Hobbit13/hackeeg-shield/eagle/BioRoboticsShield.jpg

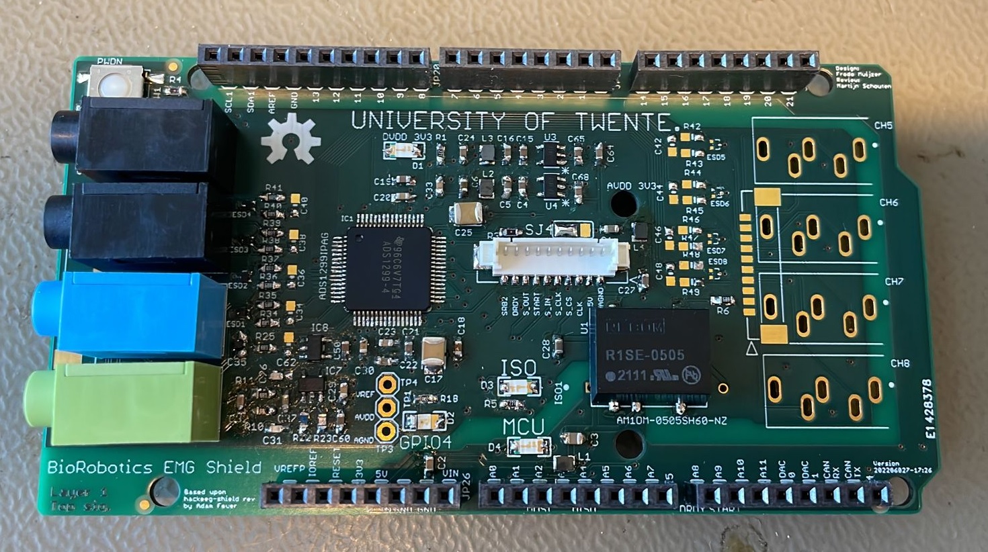
eagle/BioRoboticsShield.jpg
