Hobbit13/hackeeg-shield/eagle/biorobotics_EMG_shield.pdf

A

A

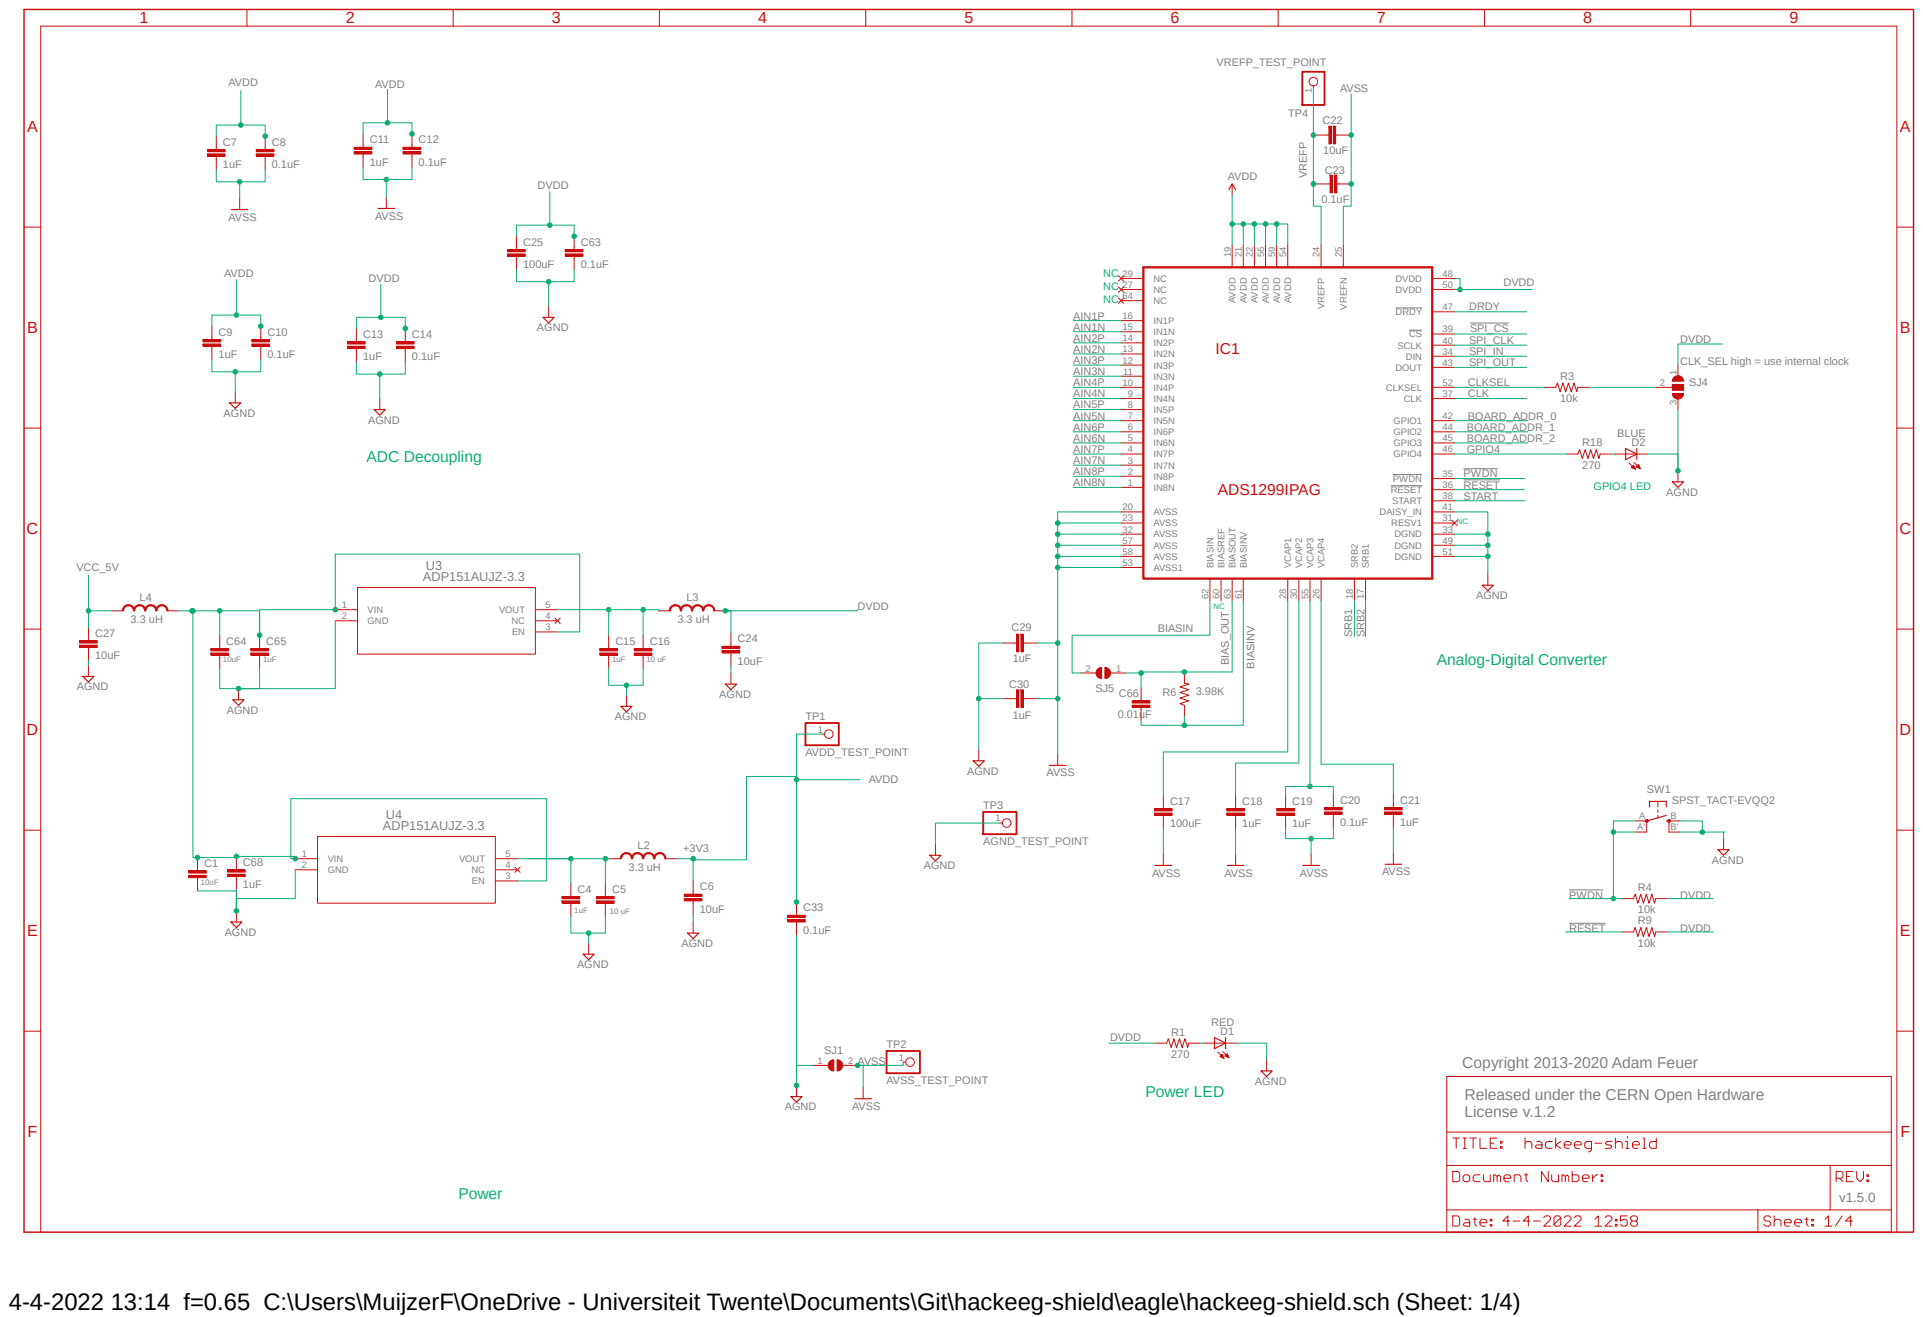
[picture p18: page 1]

DVDD
CLK_SEL high = use internal clock

BIASINV 61 BIASOUT 63 BIASREF 60 BIASIN 62

Copyright 2013-2020 Adam Feuer
Released under the CERN Open Hardware
License v.1.2

4-4-2022 13:14 f=0.65 C:\Users\MuijzerF\OneDrive - Universiteit Twente\Documents\Git\hackeeg-shield\eagle\hackeeg-shield.sch (Sheet: 1/4)

A

A

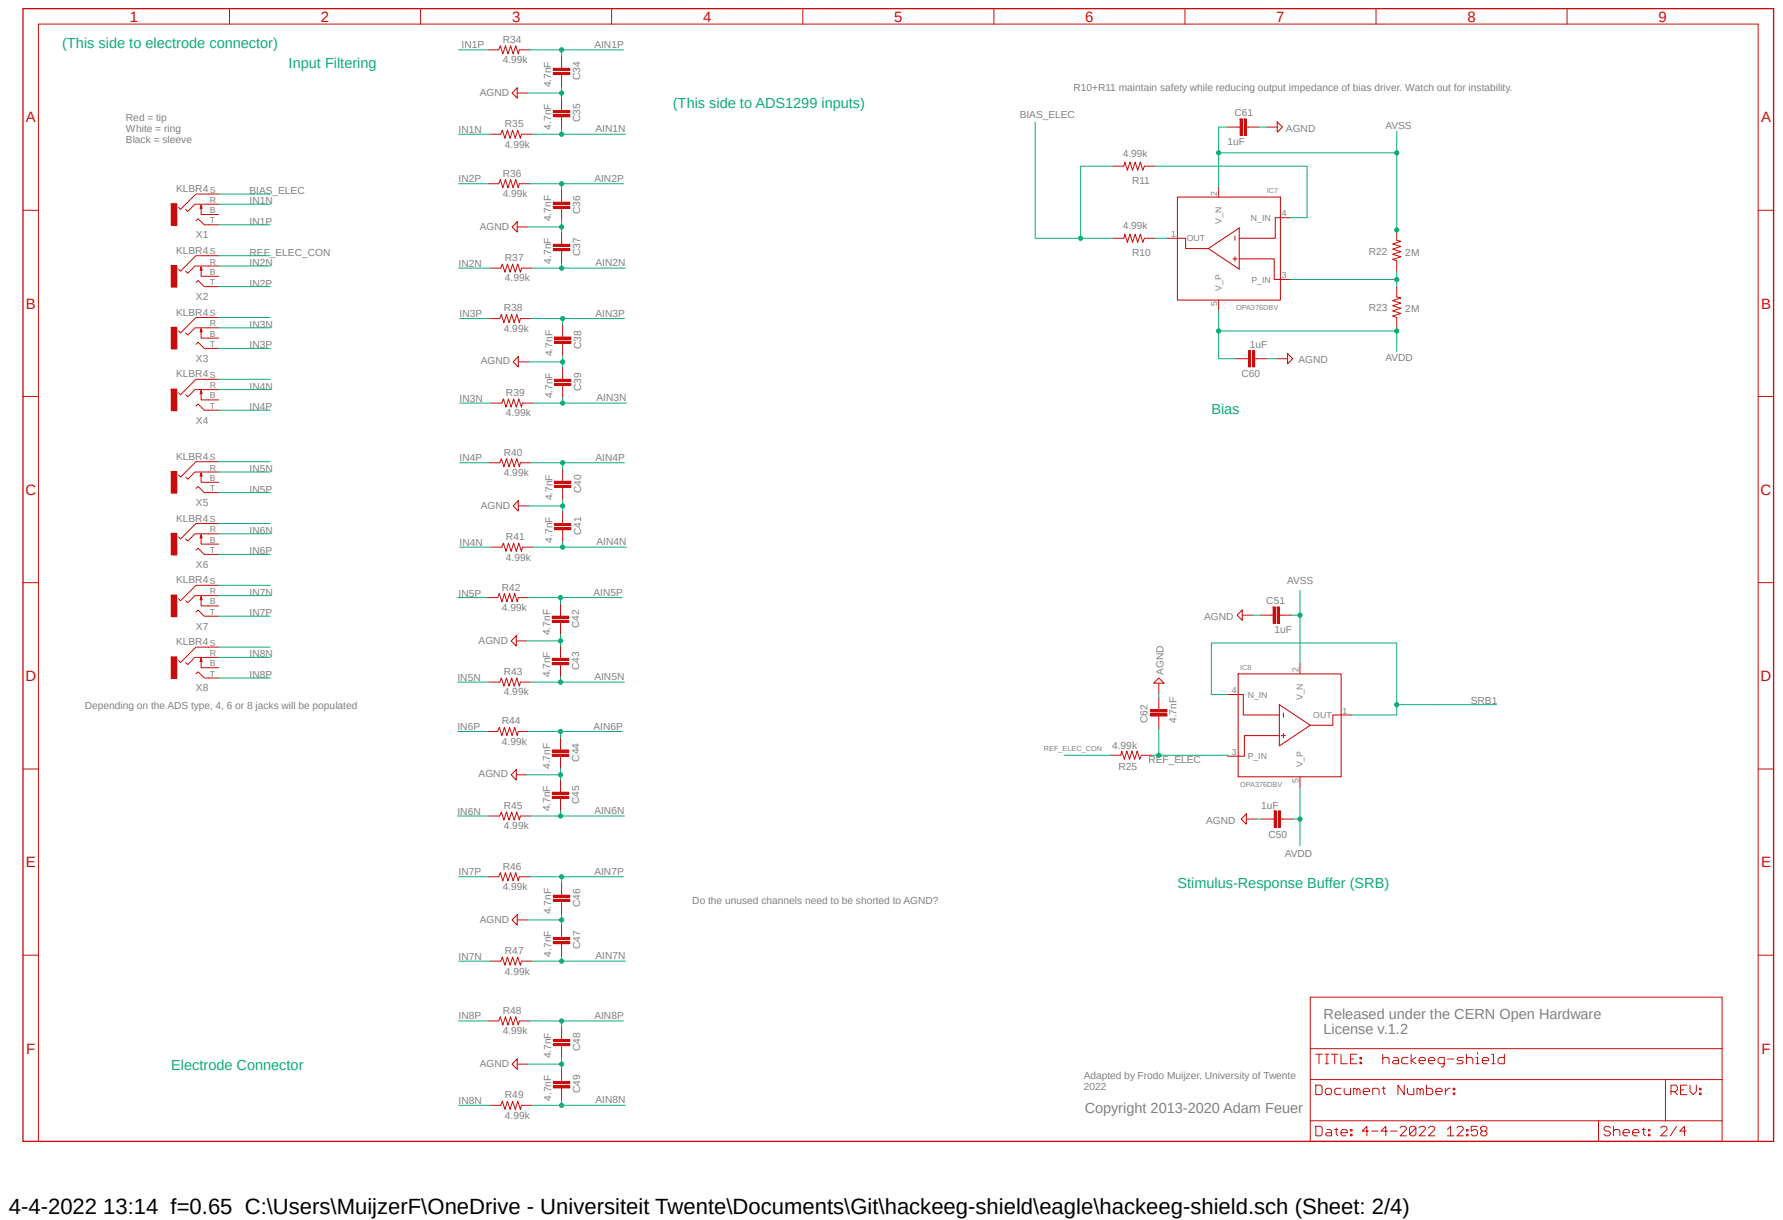
[picture p19: page 2]

(This side to electrode connector)

R10+R11 maintain safety while reducing output impedance of bias driver. Watch out for instability.

(This side to ADS1299 inputs)

Depending on the ADS type, 4, 6 or 8 jacks will be populated

Stimulus-Response Buffer (SRB)

Do the unused channels need to be shorted to AGND?

Released under the CERN Open Hardware
License v.1.2

Adapted by Frodo Muijzer, University of Twente
Copyright 2013-2020 Adam Feuer

4-4-2022 13:14 f=0.65 C:\Users\MuijzerF\OneDrive - Universiteit Twente\Documents\Git\hackeeg-shield\eagle\hackeeg-shield.sch (Sheet: 2/4)

## R1SE-0505-R

U1

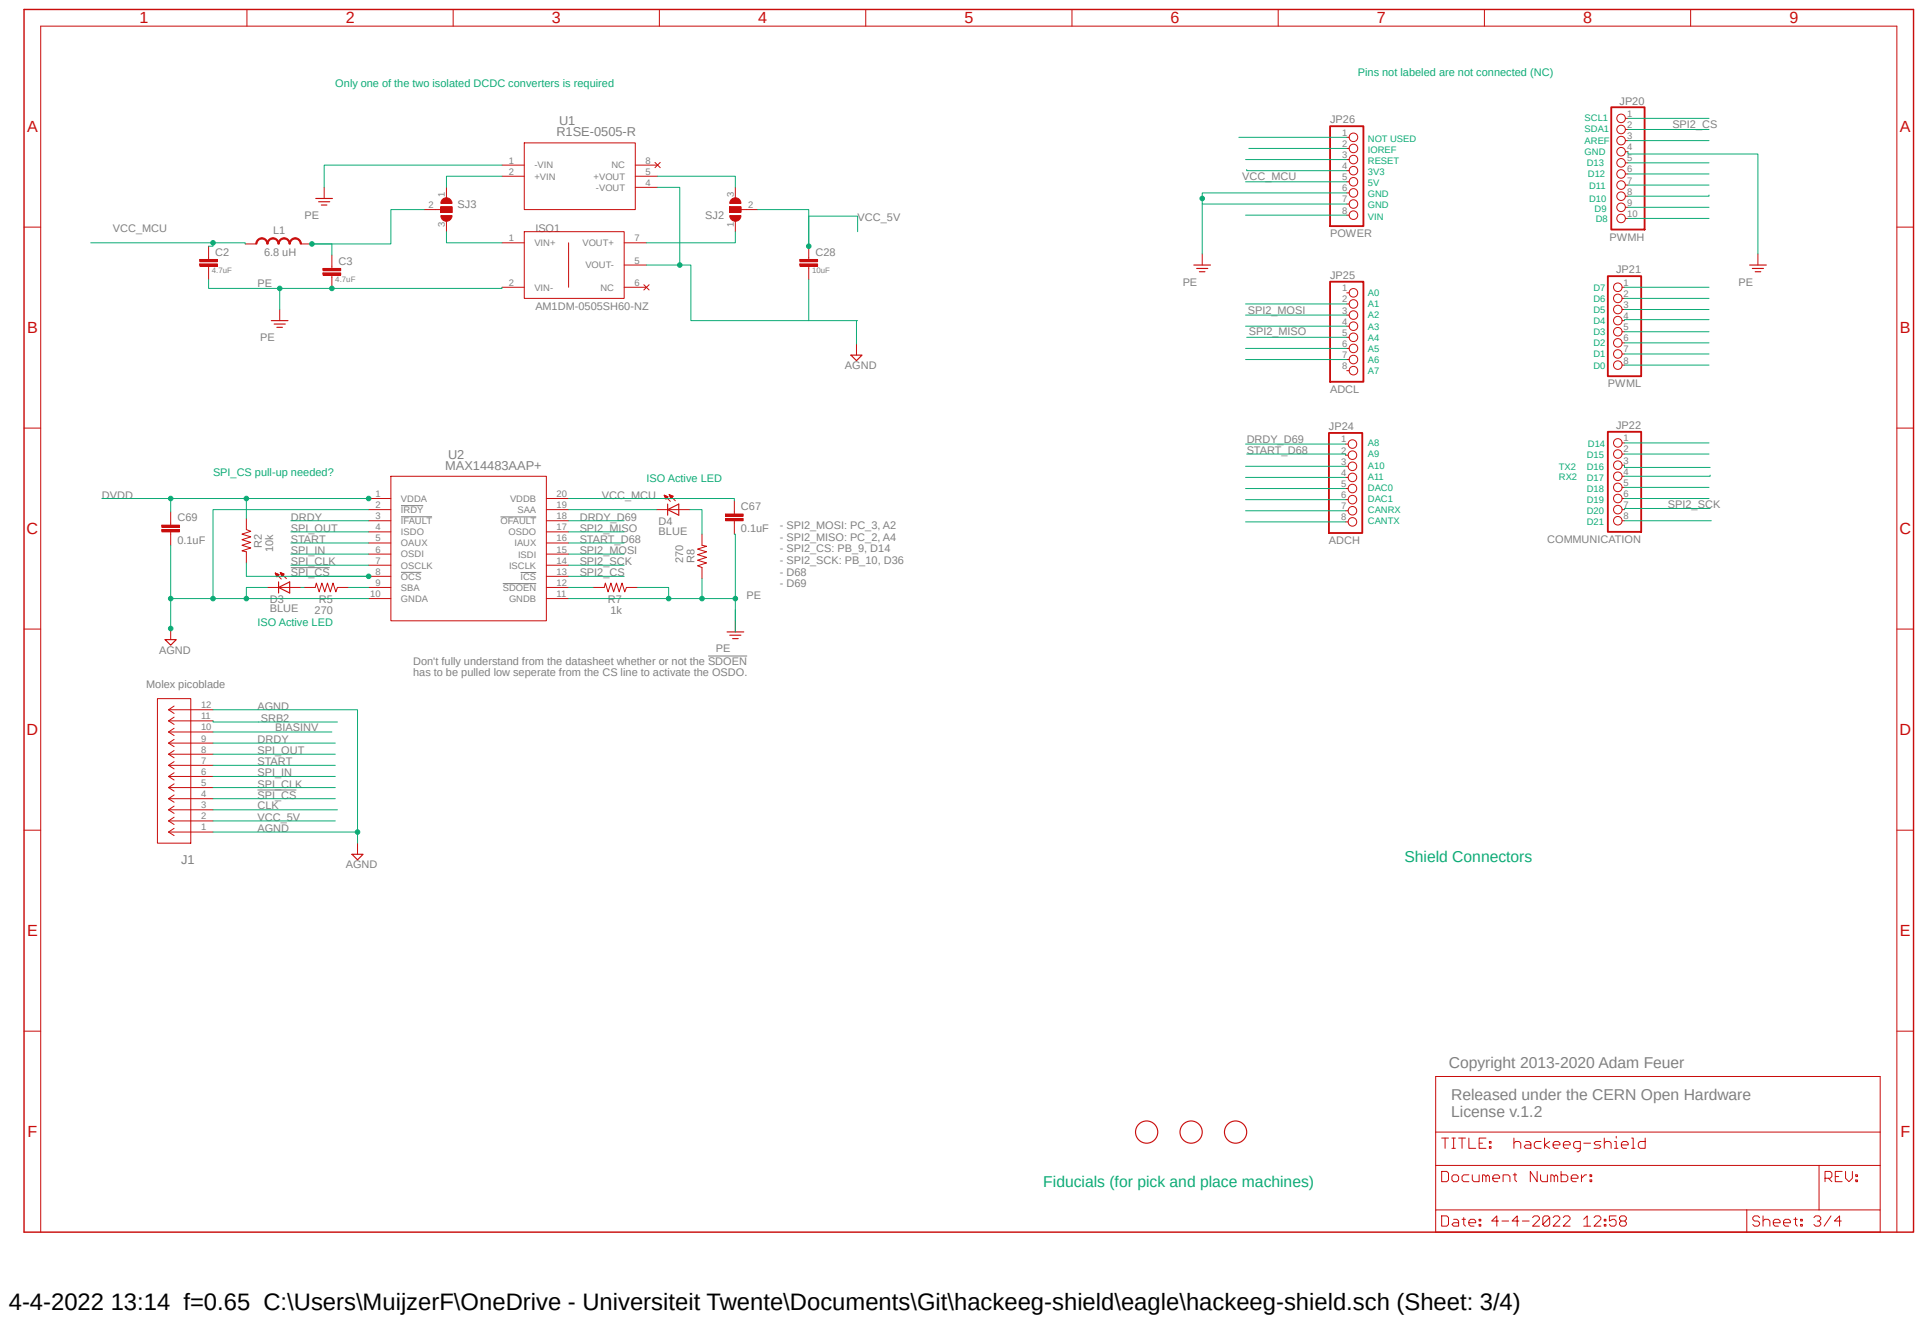
[picture p20: page 3]

Only one of the two isolated DCDC converters is required

Pins not labeled are not connected (NC)

Don't fully understand from the datasheet whether or not the SDOEN
has to be pulled low seperate from the CS line to activate the OSDO.

Copyright 2013-2020 Adam Feuer
Released under the CERN Open Hardware
License v.1.2

Fiducials (for pick and place machines)

4-4-2022 13:14 f=0.65 C:\Users\MuijzerF\OneDrive - Universiteit Twente\Documents\Git\hackeeg-shield\eagle\hackeeg-shield.sch (Sheet: 3/4)

A

A

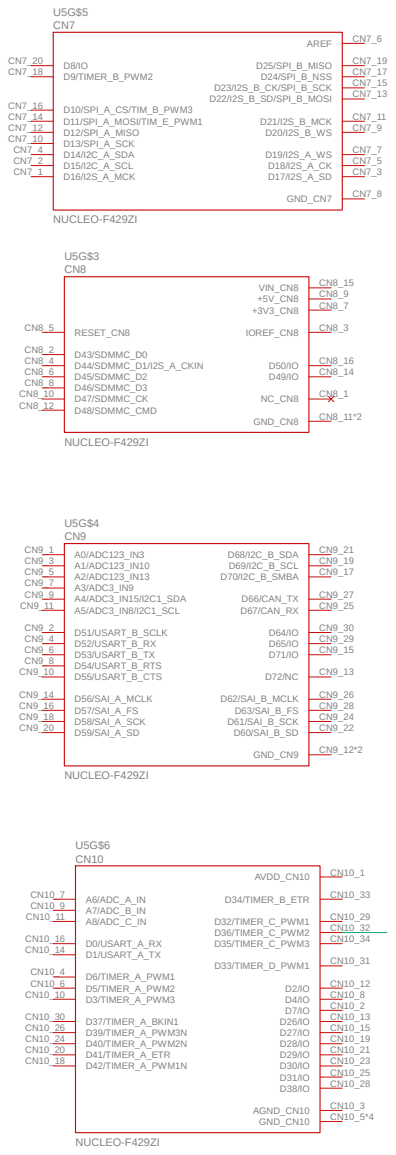
[picture p21: page 4]
NUCLEO-F429ZI; D43/SDMMC_D0 CN8_2; IOREF_CN8; D44/SDMMC_D1/I2S_A_CKIN CN8_4; RESET_CN8 CN8_5; D45/SDMMC_D2 CN8_6; D46/SDMMC_D3 CN8_8; D47/SDMMC_CK CN8_10; GND_CN8; CN8_11*2 D48/SDMMC_CMD CN8_12; VIN_CN8; A0/ADC123_IN3 CN9_1; D51/USART_B_SCLK CN9_2; A1/ADC123_IN10 CN9_3; D52/USART_B_RX CN9_4; A2/ADC123_IN13 CN9_5; D53/USART_B_TX CN9_6; A3/ADC3_IN9 CN9_7; D54/USART_B_RTS CN9_8; A4/ADC3_IN15/I2C1_SDA CN9_9; D55/USART_B_CTS CN9_10; A5/ADC3_IN8/I2C1_SCL CN9_11; GND_CN9; D56/SAI_A_MCLK CN9_14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

4-4-2022 13:14 f=0.65 C:\Users\MuijzerF\OneDrive - Universiteit Twente\Documents\Git\hackeeg-shield\eagle\hackeeg-shield.sch (Sheet: 4/4)
