Hobbit13/hackeeg-shield/docs/hackeeg-shield bottom layer.pdf

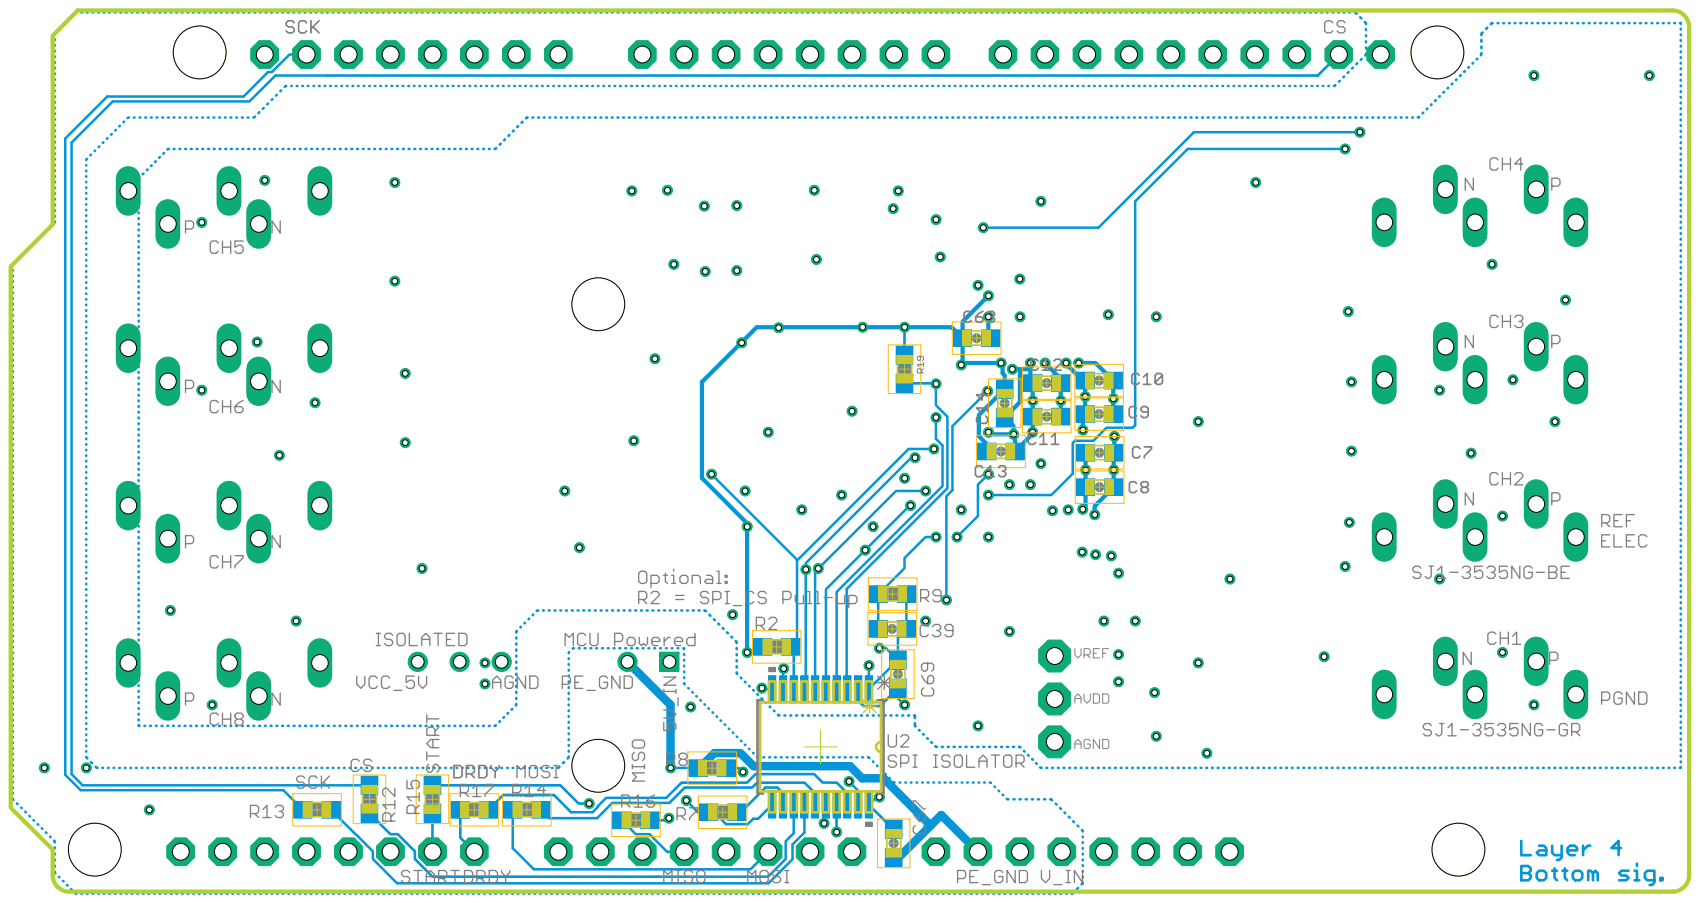
[picture p22: page 1]
