Hobbit13/hackeeg-shield/docs/hackeeg-shield top layer.pdf

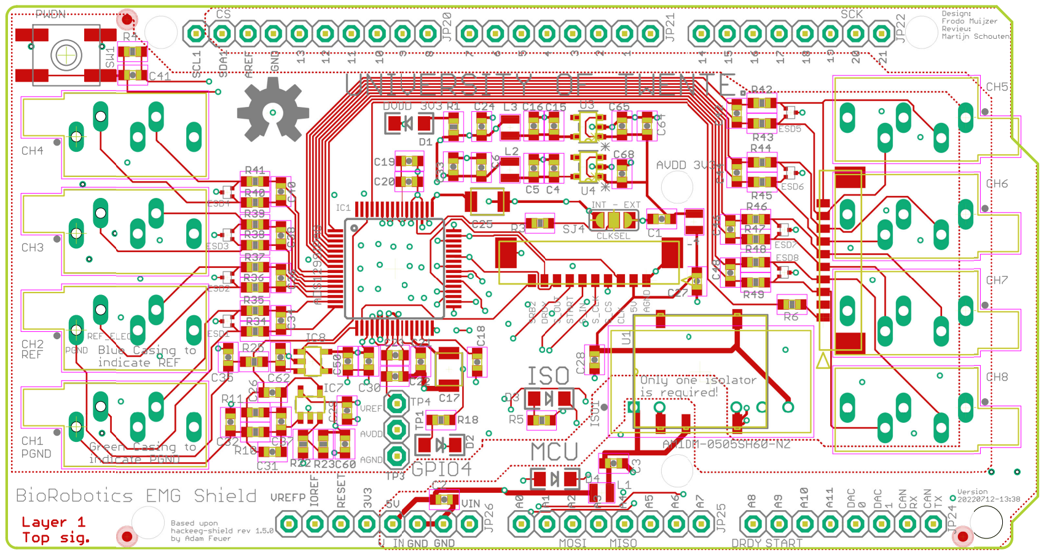
[picture p23: page 1]
