Hobbit13/hackeeg-shield/docs/hackeeg-shield brd.pdf

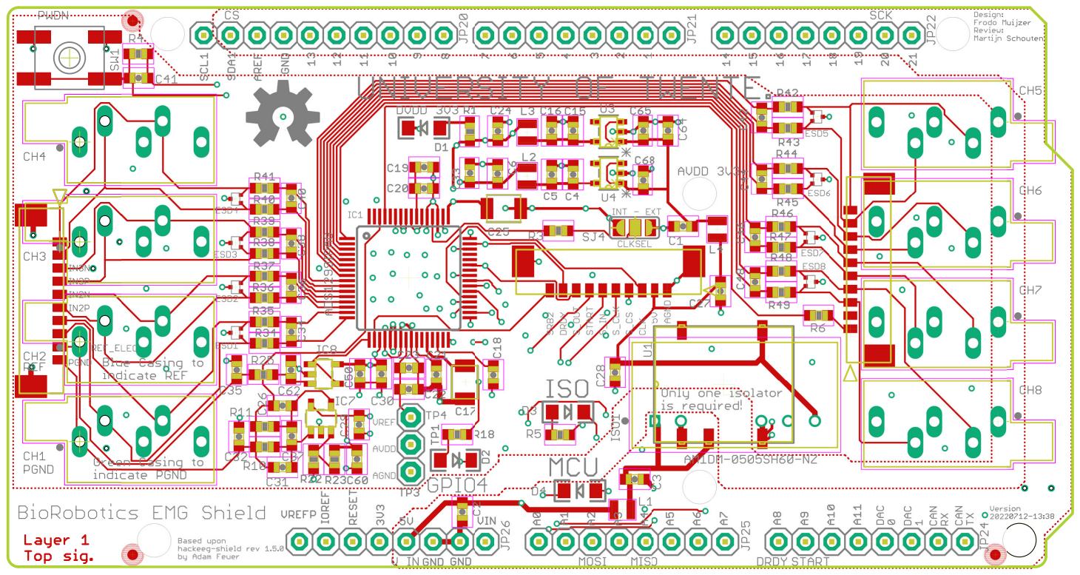
[picture p24: page 1]
