Hobbit13/hackeeg-shield/eagle/hackeeg-shield.brd

## EAGLE design eagle/hackeeg-shield.brd (2023-07-25)

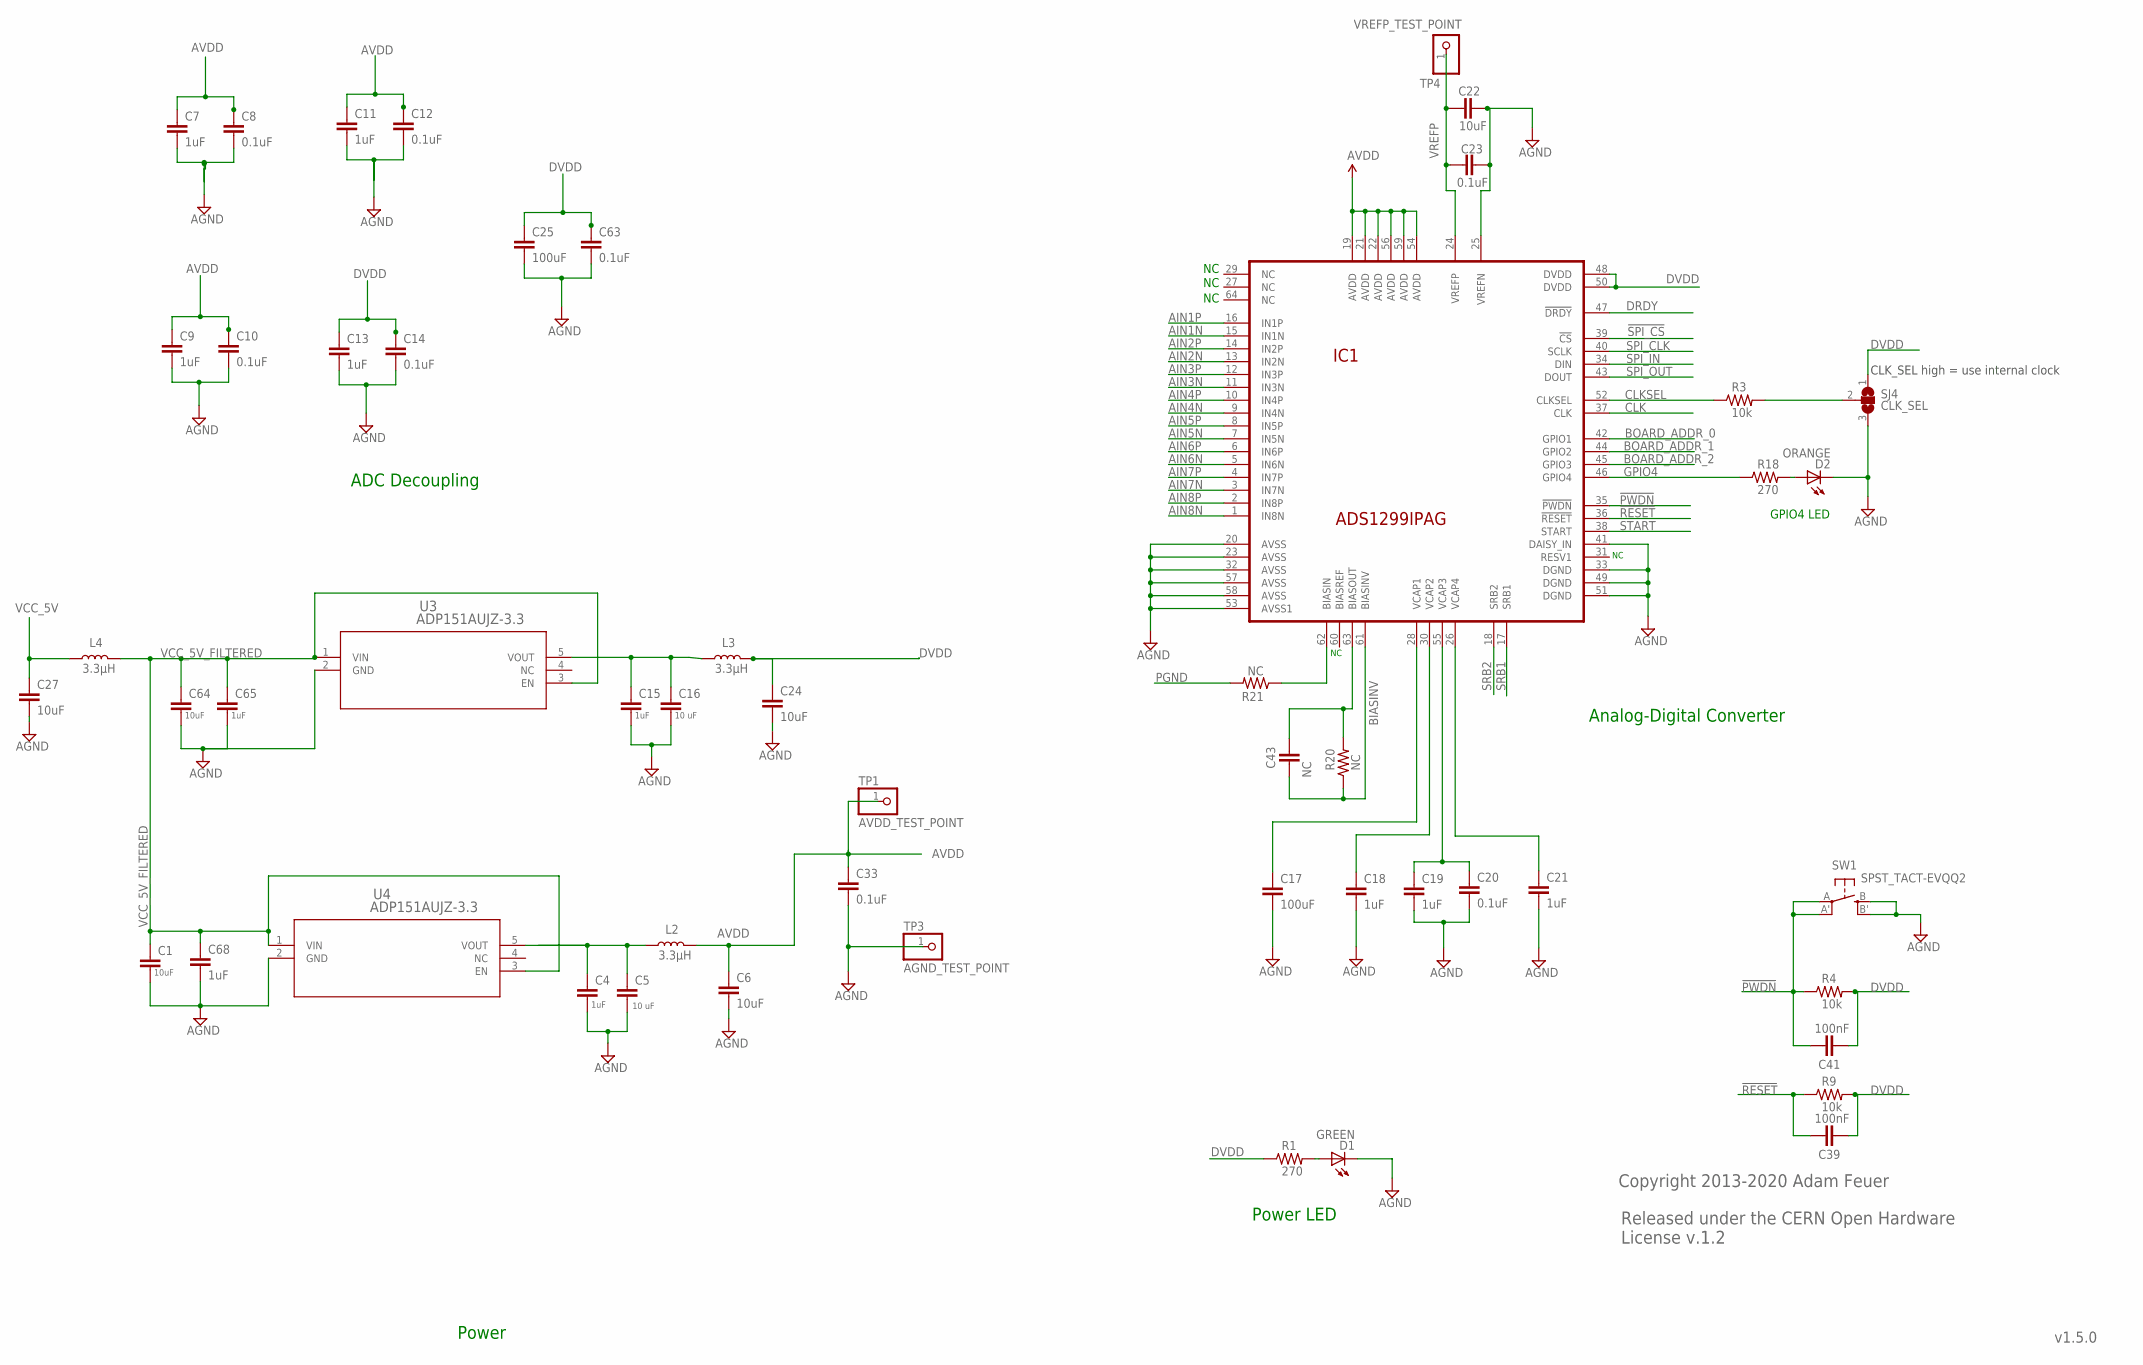
[picture p25: schematic hackeeg-shield.sch, sheet 1, ADS1299 and power supplies]

Parts:
C1, C6, C22, C24, C27, C64: 10uF; 0603-CAP
C4, C7, C9, C11, C13, C15, C18, C19, C21, C65, C68: 1uF; 0603-CAP
C5, C16: 10 uF; 0603-CAP
C8, C10, C12, C14, C20, C23, C33, C63: 0.1uF; 0603-CAP
C17, C25: 100uF; 1210
C39, C41: 100nF; 0603-CAP
C43: NC; 0603-CAP
D1: GREEN; LED-1206
D2: ORANGE; LED-1206
IC1: ADS1299IPAG; TQFP64
L2, L3, L4: 3.3μH; 0805-WIDE
R1, R18: 270; 0603-RES
R3, R4, R9: 10k; 0603-RES
R20, R21: NC; 0603-RES
SJ4: CLK_SEL; SJ_2
SW1: SPST_TACT-EVQQ2; EVQ-Q2
TP1: AVDD_TEST_POINT; 1X01
TP3: AGND_TEST_POINT; 1X01
TP4: VREFP_TEST_POINT; 1X01
U3, U4: ADP151AUJZ-3.3; UJ_5_ADI

Connections:
!PWDN: C41.1, IC1.35 (!PWDN), R4.1, SW1.A, SW1.A' (P1)
!RESET: C39.1, IC1.36 (!RESET), R9.1
!SPI_CS: IC1.39 (!CS); also elsewhere on the board
AGND: C1.2, C4.2, C5.2, C6.2, C7.2, C8.2, C9.2, C10.2, C11.2, C12.2, C13.2, C14.2, C15.2, C16.2, C17.2, C18.2, C19.2, C20.2, C21.2, C22.2, C23.2, C24.2, C25.2, C27.2, C33.2, C63.2, C64.2, C65.2, C68.2, D1.C, D2.C, IC1.20 (AVSS), IC1.23 (AVSS), IC1.25 (VREFN), IC1.32 (AVSS), IC1.33 (DGND), IC1.41 (DAISY_IN), IC1.49 (DGND), IC1.51 (DGND), IC1.53 (AVSS1), IC1.57 (AVSS), IC1.58 (AVSS), SJ4.3, SW1.B (S), SW1.B' (S1), TP3.1, U3.2 (GND), U4.2 (GND); also elsewhere on the board
AIN1N: IC1.15 (IN1N); also elsewhere on the board
AIN1P: IC1.16 (IN1P); also elsewhere on the board
AIN2N: IC1.13 (IN2N); also elsewhere on the board
AIN2P: IC1.14 (IN2P); also elsewhere on the board
AIN3N: IC1.11 (IN3N); also elsewhere on the board
AIN3P: IC1.12 (IN3P); also elsewhere on the board
AIN4N: IC1.9 (IN4N); also elsewhere on the board
AIN4P: IC1.10 (IN4P); also elsewhere on the board
AIN5N: IC1.7 (IN5N); also elsewhere on the board
AIN5P: IC1.8 (IN5P); also elsewhere on the board
AIN6N: IC1.5 (IN6N); also elsewhere on the board
AIN6P: IC1.6 (IN6P); also elsewhere on the board
AIN7N: IC1.3 (IN7N); also elsewhere on the board
AIN7P: IC1.4 (IN7P); also elsewhere on the board
AIN8N: IC1.1 (IN8N); also elsewhere on the board
AIN8P: IC1.2 (IN8P); also elsewhere on the board
AVDD: C6.1, C7.1, C8.1, C9.1, C10.1, C11.1, C12.1, C33.1, IC1.19 (AVDD), IC1.21 (AVDD), IC1.22 (AVDD), IC1.54 (AVDD), IC1.56 (AVDD), IC1.59 (AVDD), L2.2, TP1.1; also elsewhere on the board
BIASINV: C43.2, IC1.61 (BIASINV), R20.1; also elsewhere on the board
BOARD_ADDR_0: IC1.42 (GPIO1)
BOARD_ADDR_1: IC1.44 (GPIO2)
BOARD_ADDR_2: IC1.45 (GPIO3)
CLK: IC1.37 (CLK); also elsewhere on the board
CLKSEL: IC1.52 (CLKSEL), R3.1
DRDY: IC1.47 (!DRDY); also elsewhere on the board
DVDD: C13.1, C14.1, C24.1, C25.1, C39.2, C41.2, C63.1, IC1.48 (DVDD), IC1.50 (DVDD), L3.2, R1.1, R4.2, R9.2, SJ4.1; also elsewhere on the board
GPIO4: IC1.46 (GPIO4), R18.1
unnamed: C4.1, C5.1, L2.1, U4.5 (VOUT)
unnamed: C15.1, C16.1, L3.1, U3.5 (VOUT)
unnamed: C17.1, IC1.28 (VCAP1)
unnamed: C18.1, IC1.30 (VCAP2)
unnamed: C19.1, C20.1, IC1.55 (VCAP3)
unnamed: C21.1, IC1.26 (VCAP4)
unnamed: D2.A, R18.2
unnamed: D1.A, R1.2
unnamed: R3.2, SJ4.2
unnamed: C43.1, IC1.63 (BIASOUT), R20.2
unnamed: IC1.62 (BIASIN), R21.1
PGND: R21.2; also elsewhere on the board
SPI_CLK: IC1.40 (SCLK); also elsewhere on the board
SPI_IN: IC1.34 (DIN); also elsewhere on the board
SPI_OUT: IC1.43 (DOUT); also elsewhere on the board
SRB1: IC1.17 (SRB1); also elsewhere on the board
SRB2: IC1.18 (SRB2); also elsewhere on the board
START: IC1.38 (START); also elsewhere on the board
VCC_5V: C27.1, L4.1; also elsewhere on the board
VCC_5V_FILTERED: C1.1, C64.1, C65.1, C68.1, L4.2, U3.1 (VIN), U3.3 (EN), U4.1 (VIN), U4.3 (EN)
VREFP: C22.1, C23.1, IC1.24 (VREFP), TP4.1

Notes on the sheet:
Released under the CERN Open Hardware License v.1.2
Copyright 2013-2020 Adam Feuer
v1.5.0
ADC Decoupling
Power
Analog-Digital Converter
GPIO4 LED
Power LED
CLK_SEL high = use internal clock

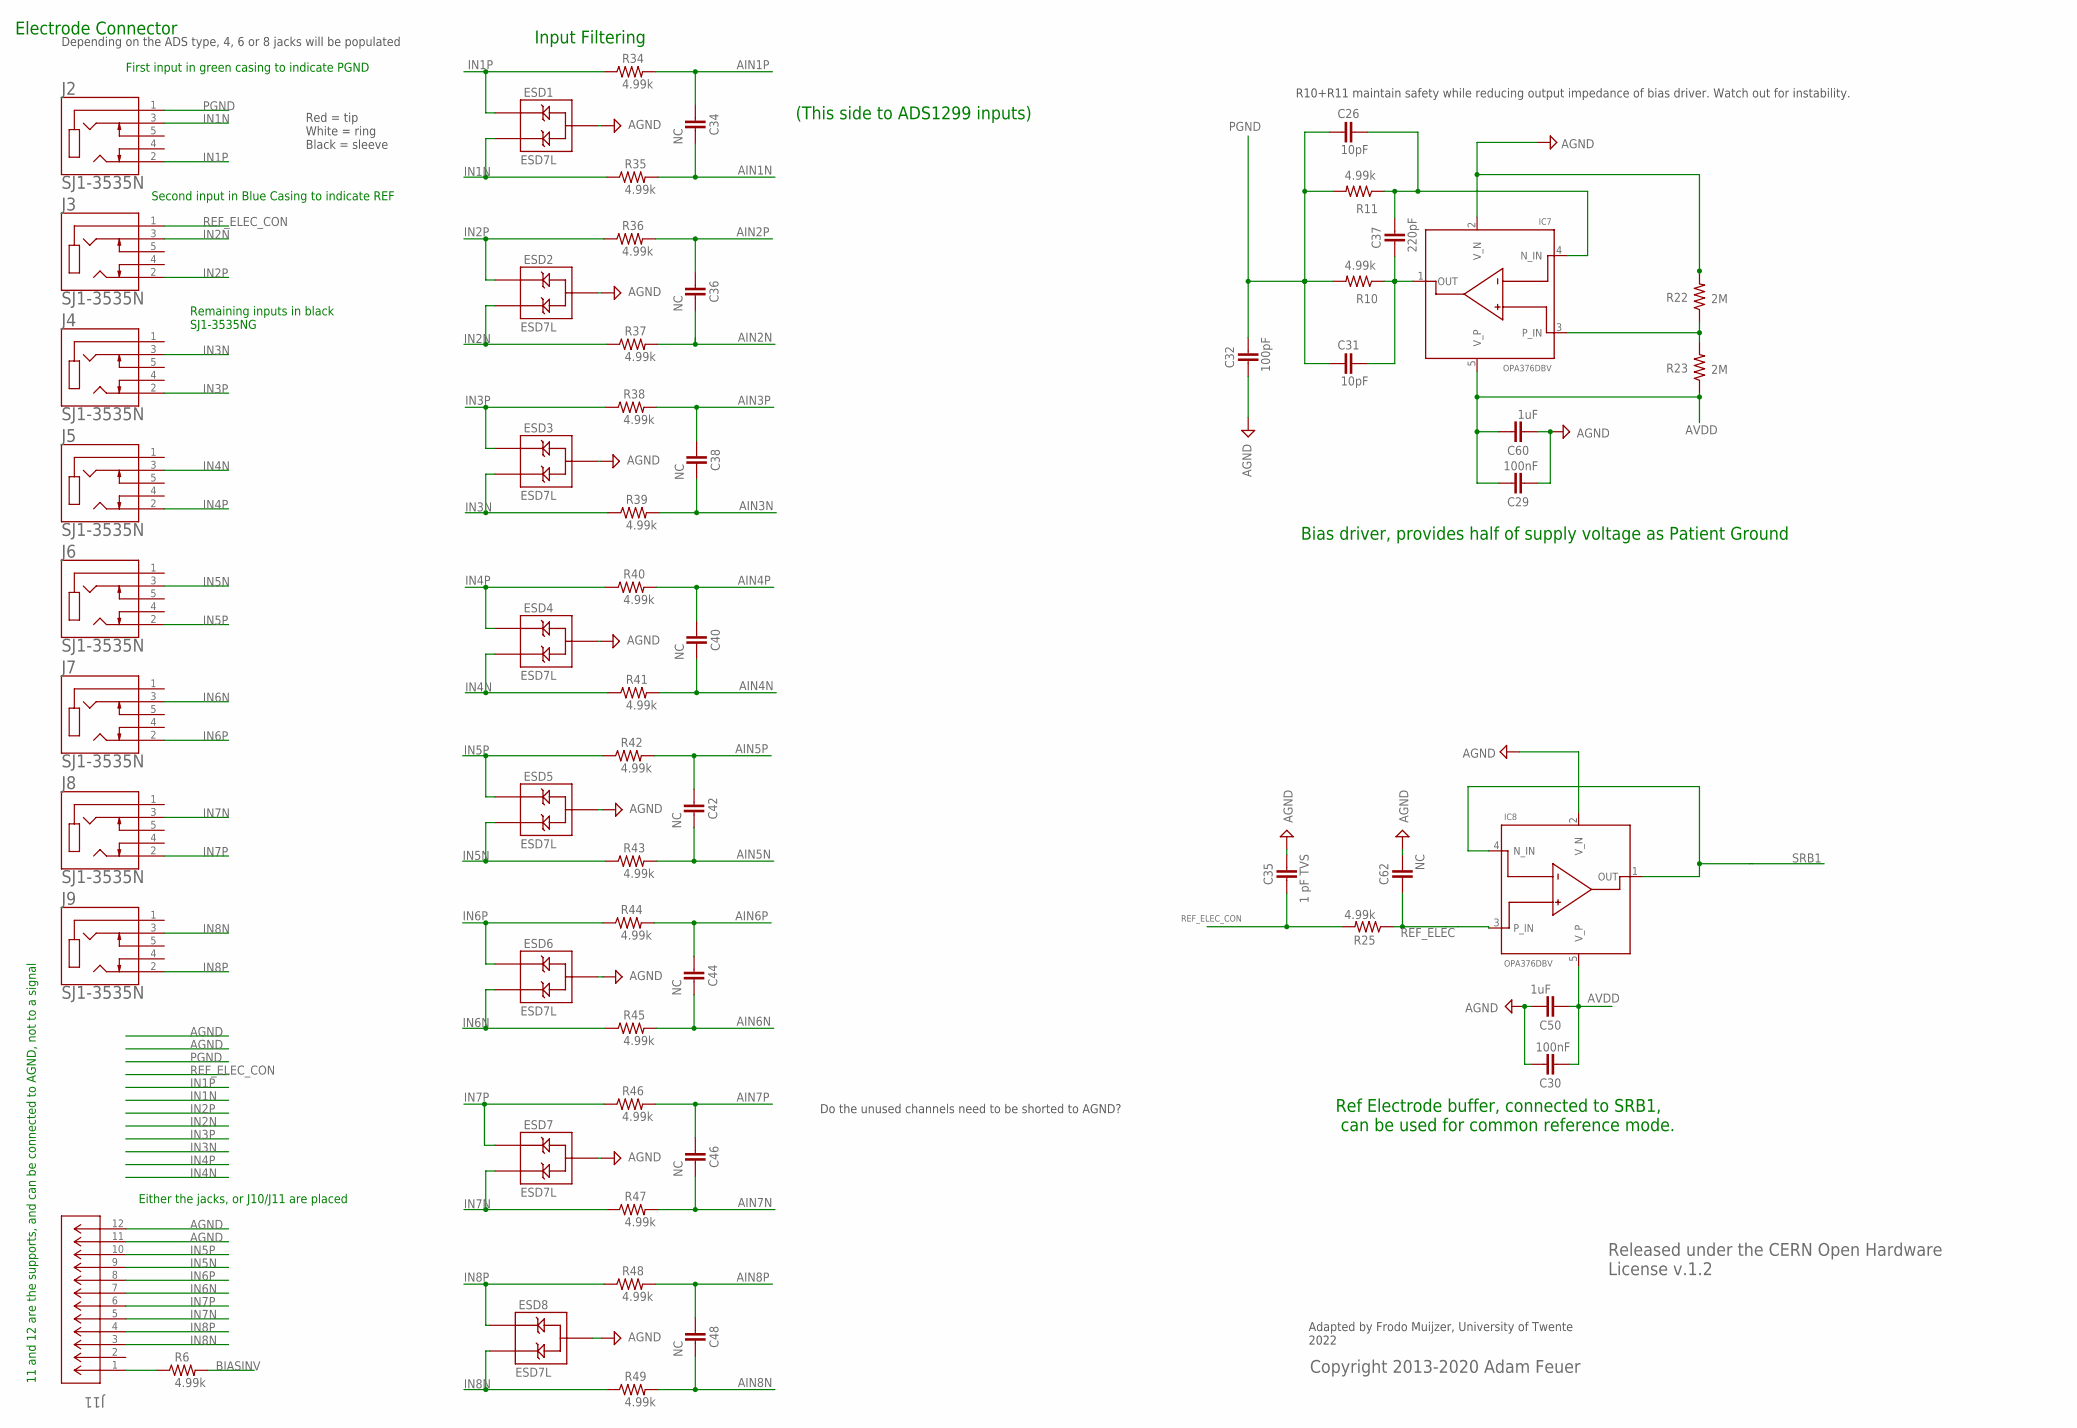
[picture p26: schematic hackeeg-shield.sch, sheet 2, Input filtering and electrode connector]

Parts:
C26, C31: 10pF; 0603-CAP
C29, C30: 100nF; 0603-CAP
C32: 100pF; 0603-CAP
C34, C36, C38, C40, C42, C44, C46, C48, C62: NC; 0603-CAP
C35: 1 pF TVS; 0603-CAP
C37: 220pF; 0603-CAP
C50, C60: 1uF; 0603-CAP
ESD1, ESD2, ESD3, ESD4, ESD5, ESD6, ESD7, ESD8: ESD7L; SOT-723
IC7, IC8: OPA376DBV; SOT23-5
J2, J3, J4, J5, J6, J7, J8, J9: SJ1-3535N; CUI_SJ1-3535N
J11: 533981071; CON_533981071
R6, R10, R11, R25, R34, R35, R36, R37, R38, R39, R40, R41, R42, R43, R44, R45, R46, R47, R48, R49: 4.99k; 0603-RES
R22, R23: 2M; 0603-RES

Connections:
AGND: C29.2, C30.1, C32.1, C35.2, C50.2, C60.2, C62.2, ESD1.P$3, ESD2.P$3, ESD3.P$3, ESD4.P$3, ESD5.P$3, ESD6.P$3, ESD7.P$3, ESD8.P$3, IC7.2 (V_N), IC8.2 (V_N), J11.11, J11.12, R22.2; also elsewhere on the board
AIN1N: C34.2, R35.2; also elsewhere on the board
AIN1P: C34.1, R34.2; also elsewhere on the board
AIN2N: C36.2, R37.2; also elsewhere on the board
AIN2P: C36.1, R36.2; also elsewhere on the board
AIN3N: C38.2, R39.2; also elsewhere on the board
AIN3P: C38.1, R38.2; also elsewhere on the board
AIN4N: C40.2, R41.2; also elsewhere on the board
AIN4P: C40.1, R40.2; also elsewhere on the board
AIN5N: C42.2, R43.2; also elsewhere on the board
AIN5P: C42.1, R42.2; also elsewhere on the board
AIN6N: C44.2, R45.2; also elsewhere on the board
AIN6P: C44.1, R44.2; also elsewhere on the board
AIN7N: C46.2, R47.2; also elsewhere on the board
AIN7P: C46.1, R46.2; also elsewhere on the board
AIN8N: C48.2, R49.2; also elsewhere on the board
AIN8P: C48.1, R48.2; also elsewhere on the board
AVDD: C29.1, C30.2, C50.1, C60.1, IC7.5 (V_P), IC8.5 (V_P), R23.1; also elsewhere on the board
BIASINV: R6.2; also elsewhere on the board
IN1N: ESD1.P$2, J2.3, R35.1
IN1P: ESD1.P$1, J2.2, R34.1
IN2N: ESD2.P$2, J3.3, R37.1
IN2P: ESD2.P$1, J3.2, R36.1
IN3N: ESD3.P$2, J4.3, R39.1
IN3P: ESD3.P$1, J4.2, R38.1
IN4N: ESD4.P$2, J5.3, R41.1
IN4P: ESD4.P$1, J5.2, R40.1
IN5N: ESD5.P$2, J6.3, J11.9, R43.1
IN5P: ESD5.P$1, J6.2, J11.10, R42.1
IN6N: ESD6.P$2, J7.3, J11.7, R45.1
IN6P: ESD6.P$1, J7.2, J11.8, R44.1
IN7N: ESD7.P$2, J8.3, J11.5, R47.1
IN7P: ESD7.P$1, J8.2, J11.6, R46.1
IN8N: ESD8.P$2, J9.3, J11.3, R49.1
IN8P: ESD8.P$1, J9.2, J11.4, R48.1
unnamed: J11.1, R6.1
unnamed: IC7.3 (P_IN), R22.1, R23.2
unnamed: C31.2, C37.1, IC7.1 (OUT), R10.1
unnamed: C26.2, C37.2, IC7.4 (N_IN), R11.1
PGND: C26.1, C31.1, C32.2, J2.1, R10.2, R11.2; also elsewhere on the board
REF_ELEC: C62.1, IC8.3 (P_IN), R25.1
REF_ELEC_CON: C35.1, J3.1, R25.2
SRB1: IC8.1 (OUT), IC8.4 (N_IN); also elsewhere on the board

Notes on the sheet:
Electrode Connector
Ref Electrode buffer, connected to SRB1, can be used for common reference mode.
Released under the CERN Open Hardware License v.1.2
Copyright 2013-2020 Adam Feuer
Input Filtering
(This side to ADS1299 inputs)
Red = tip White = ring Black = sleeve
R10+R11 maintain safety while reducing output impedance of bias driver. Watch out for instability.
Depending on the ADS type, 4, 6 or 8 jacks will be populated
Do the unused channels need to be shorted to AGND?
Adapted by Frodo Muijzer, University of Twente 2022
Bias driver, provides half of supply voltage as Patient Ground
First input in green casing to indicate PGND
Second input in Blue Casing to indicate REF
Remaining inputs in black SJ1-3535NG
11 and 12 are the supports, and can be connected to AGND, not to a signal
Either the jacks, or J10/J11 are placed

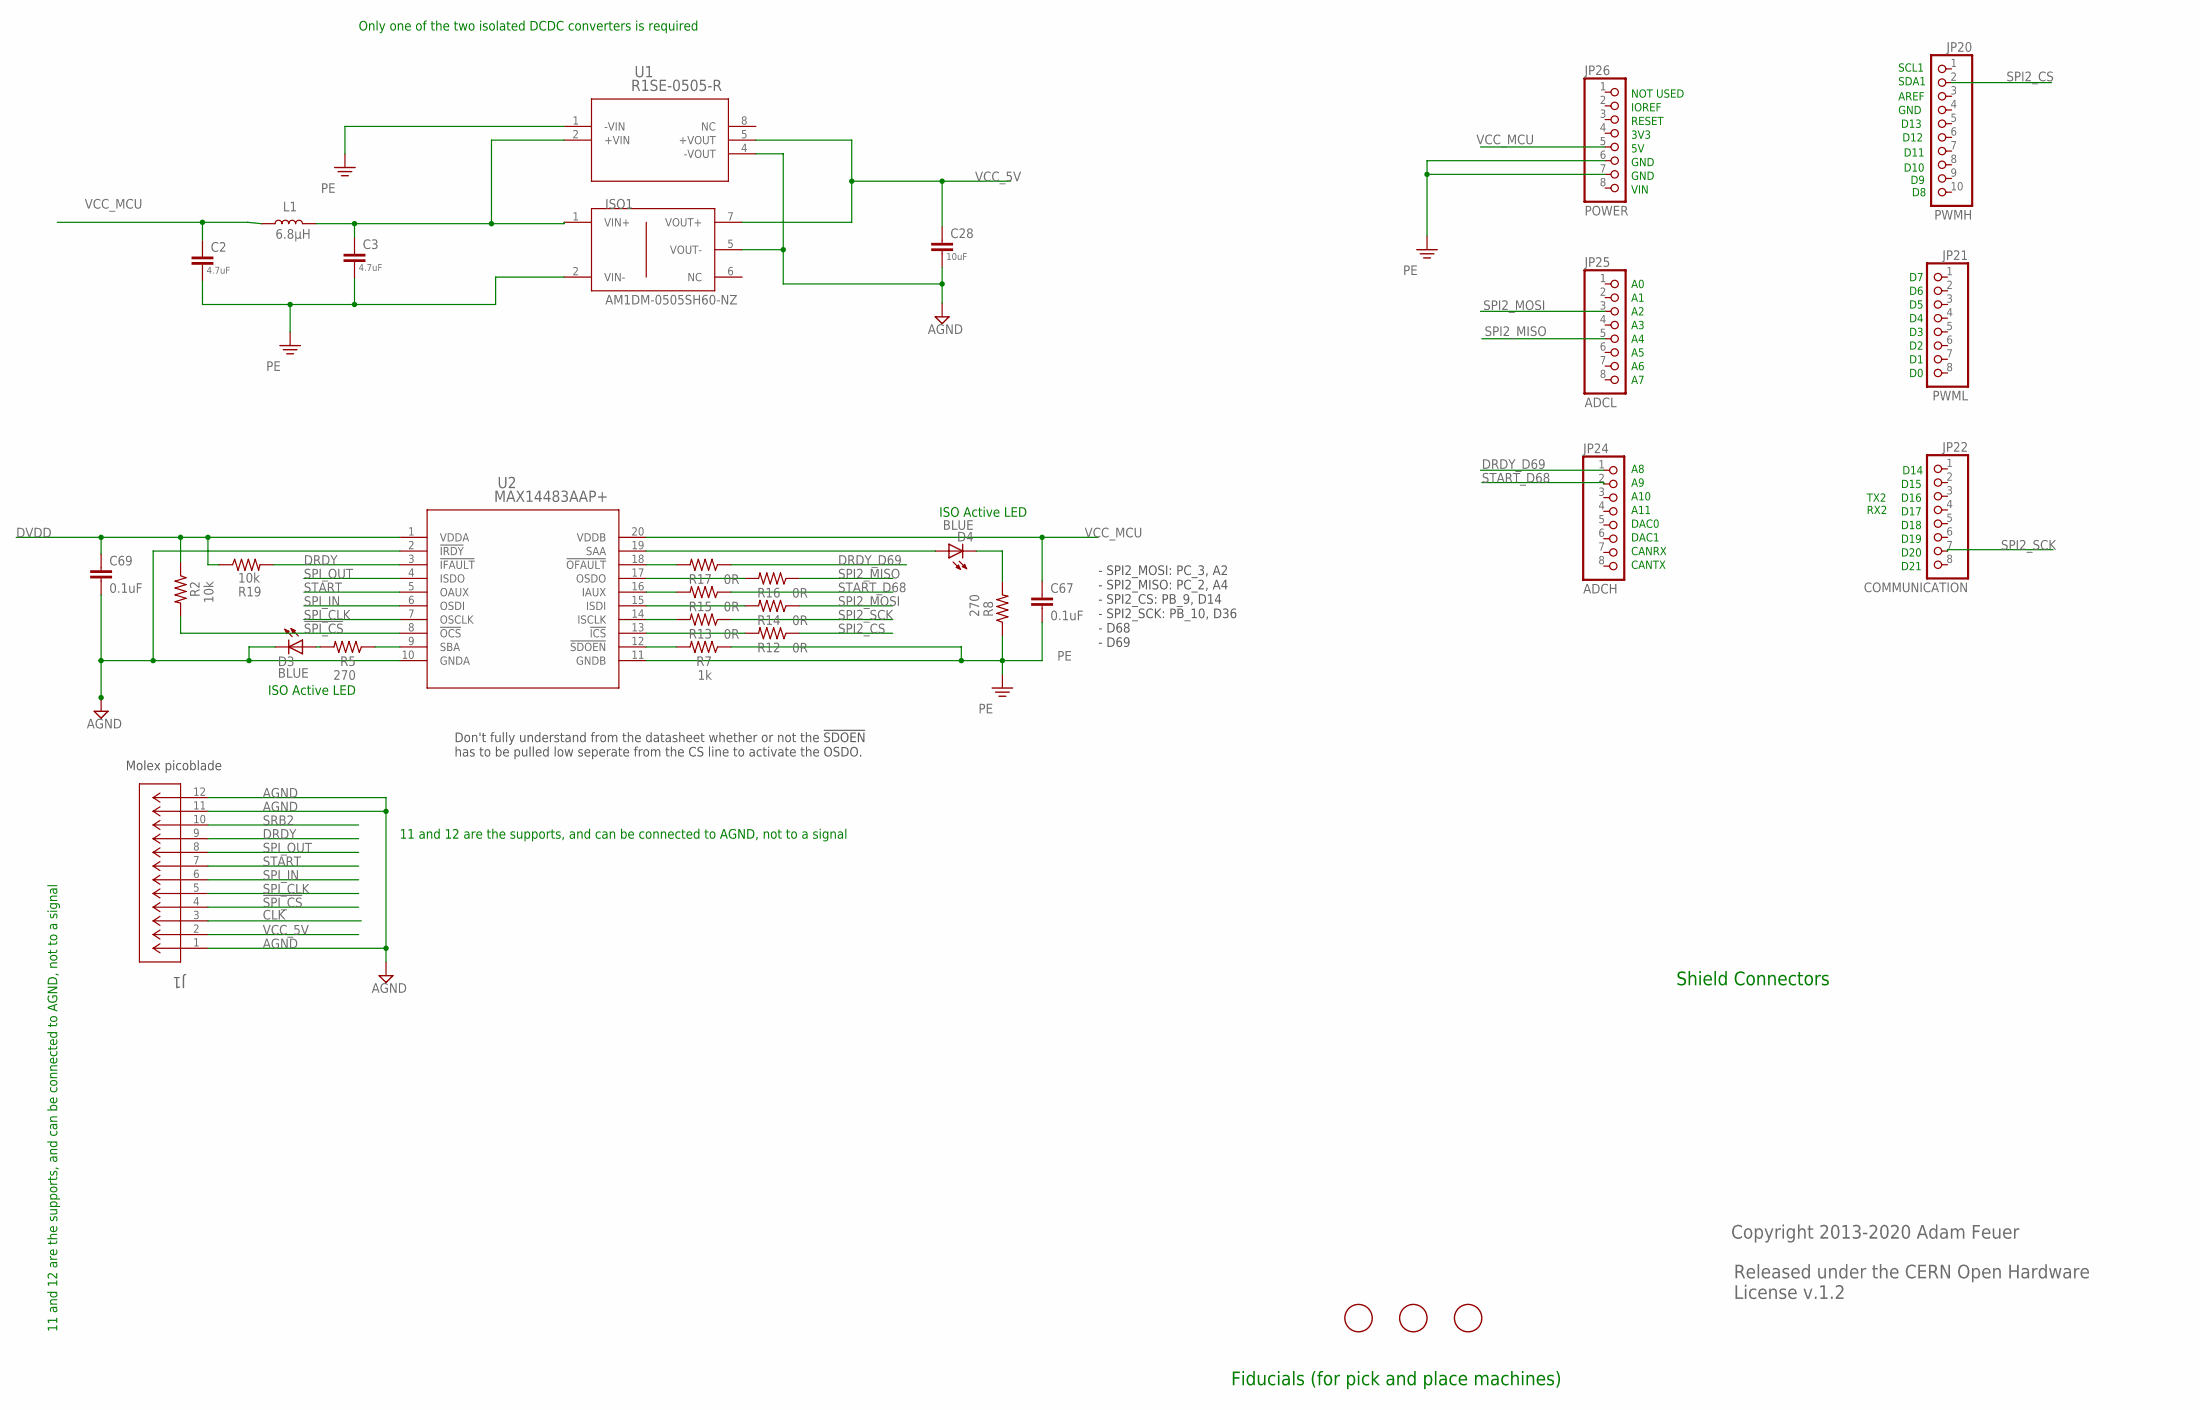
[picture p27: schematic hackeeg-shield.sch, sheet 3, Board to board connectors, isolation and additional connect…]

Parts:
C2, C3: 4.7uF; 0603-CAP
C28: 10uF; 0603-CAP
C67, C69: 0.1uF; 0603-CAP
D3, D4: BLUE; LED-1206
ISO1: AM1DM-0505SH60-NZ; SIP1005W50P254L1965H1265Q7
J1: 533981071; CON_533981071
JP20: PWMH; 1X10
JP21: PWML; 1X08
JP22: COMMUNICATION; 1X08
JP24: ADCH; 1X08
JP25: ADCL; 1X08
JP26: POWER; 1X08
L1: 6.8μH; 0805-WIDE
R2, R19: 10k; 0603-RES
R5, R8: 270; 0603-RES
R7: 1k; 0603-RES
R12, R13, R14, R15, R16, R17: 0R; 0603-RES
U1: R1SE-0505-R; R1SE-0505-R_RCP
U2: MAX14483AAP+; 21-0056C_20_MXM
U$2, U$5, U$6: FIDUCIAL; FIDUCIAL_1MM

Connections:
!SPI_CS: J1.4, R2.2, U2.8 (!OCS); also elsewhere on the board
AGND: C28.2, C69.2, D3.C, ISO1.5 (VOUT-), J1.1, J1.11, J1.12, U1.4 (-VOUT), U2.2 (!IRDY), U2.10 (GNDA); also elsewhere on the board
CLK: J1.3; also elsewhere on the board
DRDY: J1.9, R19.2, U2.3 (!IFAULT); also elsewhere on the board
DRDY_D69: JP24.1, R17.1
DVDD: C69.1, R2.1, R19.1, U2.1 (VDDA); also elsewhere on the board
unnamed: C3.1, ISO1.1 (VIN+), L1.2, U1.2 (+VIN)
unnamed: D4.A, U2.19 (SAA)
unnamed: D3.A, R5.2
unnamed: R5.1, U2.9 (SBA)
unnamed: R17.2, U2.18 (!OFAULT)
unnamed: D4.C, R8.2
unnamed: R12.2, U2.13 (!ICS)
unnamed: R13.2, U2.14 (ISCLK)
unnamed: R14.2, U2.15 (ISDI)
unnamed: R15.2, U2.16 (IAUX)
unnamed: R16.2, U2.17 (OSDO)
unnamed: R7.2, U2.12 (!SDOEN)
PE: C2.2, C3.2, C67.2, ISO1.2 (VIN-), JP26.6, JP26.7, R7.1, R8.1, U1.1 (-VIN), U2.11 (GNDB)
SPI2_CS: JP20.2, R12.1
SPI2_MISO: JP25.5, R16.1
SPI2_MOSI: JP25.3, R14.1
SPI2_SCK: JP22.7, R13.1
SPI_CLK: J1.5, U2.7 (OSCLK); also elsewhere on the board
SPI_IN: J1.6, U2.6 (OSDI); also elsewhere on the board
SPI_OUT: J1.8, U2.4 (ISDO); also elsewhere on the board
SRB2: J1.10; also elsewhere on the board
START: J1.7, U2.5 (OAUX); also elsewhere on the board
START_D68: JP24.2, R15.1
VCC_5V: C28.1, ISO1.7 (VOUT+), J1.2, U1.5 (+VOUT); also elsewhere on the board
VCC_MCU: C2.1, C67.1, JP26.5, L1.1, U2.20 (VDDB)

Notes on the sheet:
Released under the CERN Open Hardware License v.1.2
Copyright 2013-2020 Adam Feuer
Shield Connectors
SCL1
SDA1
AREF
GND
D14
D15
D16
D17
D18
D19
D20
D21
A10
A11
DAC0
DAC1
CANRX
CANTX
NOT USED
IOREF
RESET
3V3
VIN
Fiducials (for pick and place machines)
TX2
RX2
D13
D12
D11
D10
Only one of the two isolated DCDC converters is required
ISO Active LED
- SPI2_MOSI: PC_3, A2 - SPI2_MISO: PC_2, A4 - SPI2_CS: PB_9, D14 - SPI2_SCK: PB_10, D36 - D68 - D69
Don't fully understand from the datasheet whether or not the !SDOEN has to be pulled low seperate from the CS line to activate the OSDO.
Molex picoblade
11 and 12 are the supports, and can be connected to AGND, not to a signal

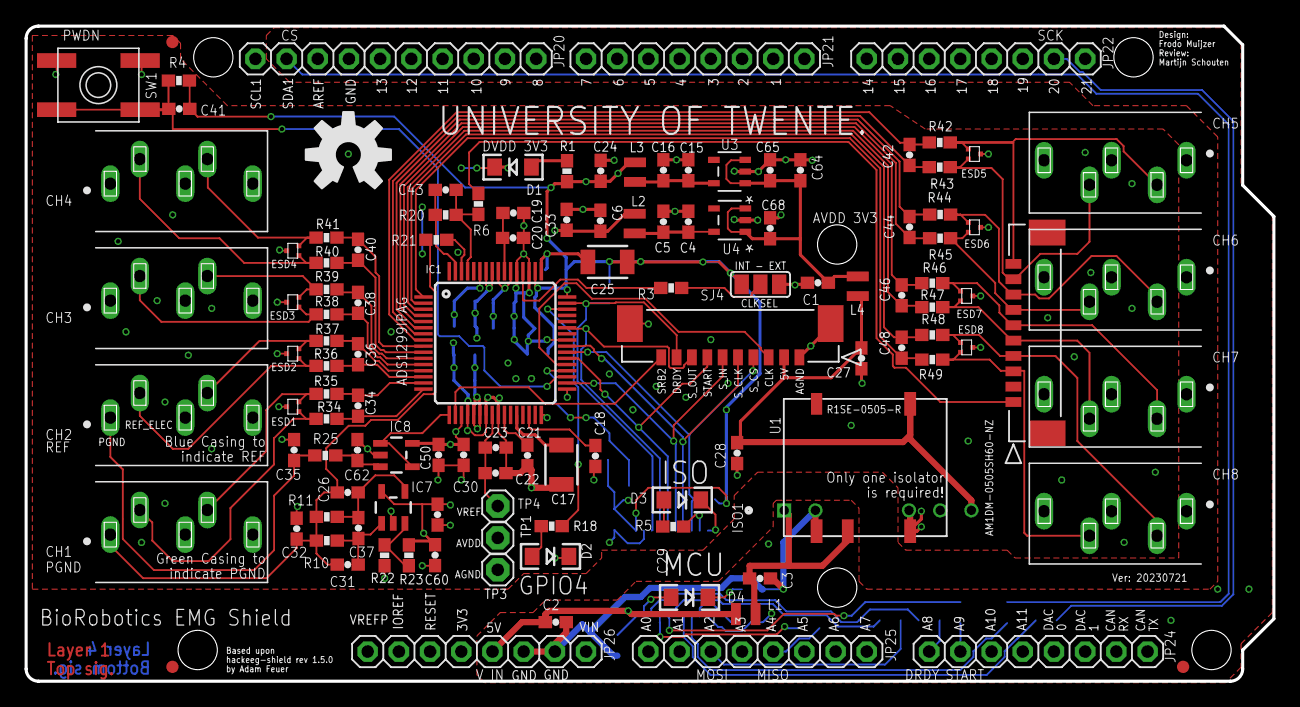
[picture p28: board eagle/hackeeg-shield.brd from above]

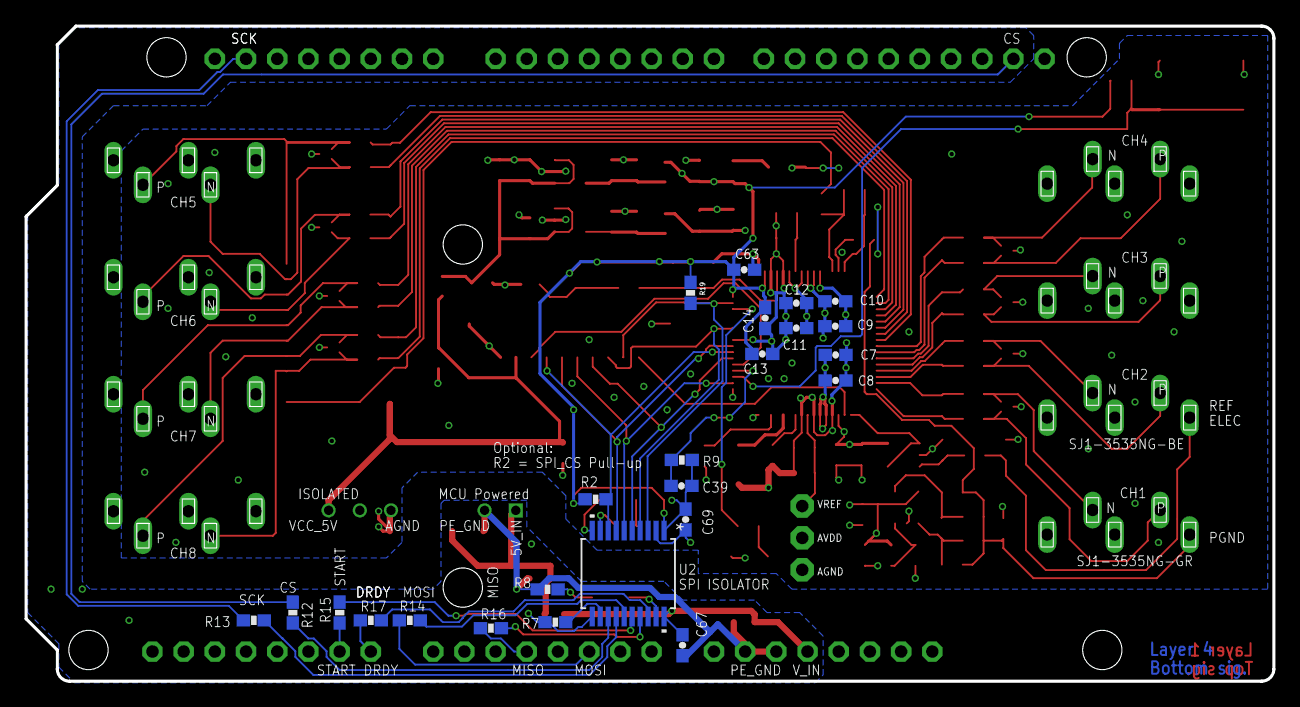
[picture p29: board eagle/hackeeg-shield.brd from below]

Board: 4 copper layers, 101.6 x 53.3 mm, 144 parts (24 on the bottom side), 90 nets.

Other parts of the board:
U$1: OSHW-LOGO-L
