Hobbit13/hackeeg-shield/eagle - Copy/hackeeg-connector-8-vertical.brd

## EAGLE design eagle - Copy/hackeeg-connector-8-vertical.brd (2022-07-28, an earlier design)

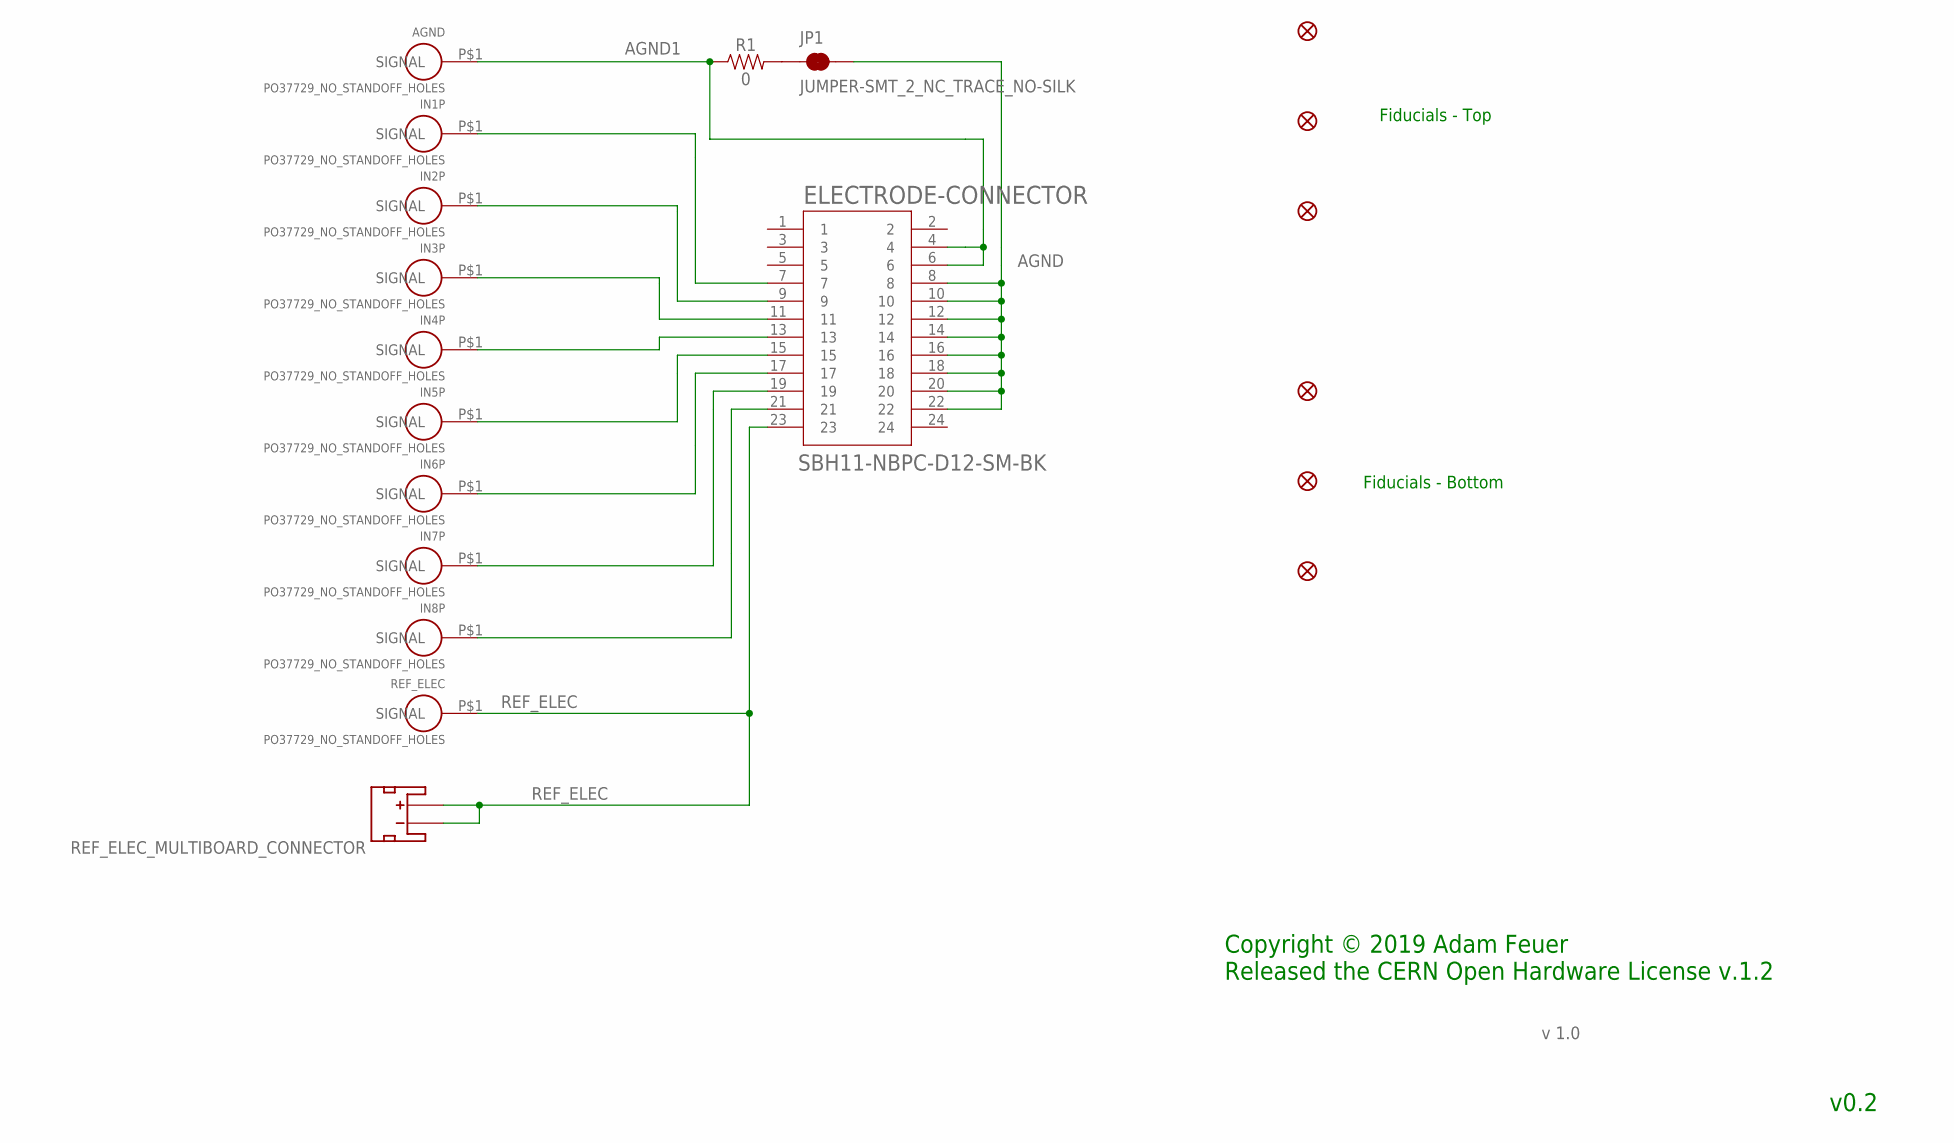
[picture p30: schematic hackeeg-connector-8-vertical.sch, HACKEEG 8 Position Connector Board]

Parts:
AGND: PO37729_NO_STANDOFF_HOLES; SIMPLE0
ELECTRODE-CONNECTOR: SBH11-NBPC-D12-SM-BK; SULLINS_SBH11-NBPC-D12-SM-BK
FD1, FD2, FD3, FD4, FD5, FD6: FIDUCIAL1X2; FIDUCIAL-1X2
IN1P, IN2P, IN3P, IN4P, IN5P, IN6P, IN7P, IN8P: PO37729_NO_STANDOFF_HOLES; SIMPLE0
JP1: JUMPER-SMT_2_NC_TRACE_NO-SILK; SMT-JUMPER_2_NC_TRACE_NO-SILK
R1: 0; 0603
REF_ELEC: PO37729_NO_STANDOFF_HOLES; SIMPLE0
REF_ELEC_MULTIBOARD_CONNECTOR: JST_2MM_MALE; JST-2-SMD

Connections:
AGND: ELECTRODE-CONNECTOR.8, ELECTRODE-CONNECTOR.10, ELECTRODE-CONNECTOR.12, ELECTRODE-CONNECTOR.14, ELECTRODE-CONNECTOR.16, ELECTRODE-CONNECTOR.18, ELECTRODE-CONNECTOR.20, ELECTRODE-CONNECTOR.22, JP1.2
AGND1: AGND.P$1, ELECTRODE-CONNECTOR.4, ELECTRODE-CONNECTOR.6, R1.1
unnamed: ELECTRODE-CONNECTOR.7, IN1P.P$1
unnamed: ELECTRODE-CONNECTOR.9, IN2P.P$1
unnamed: ELECTRODE-CONNECTOR.11, IN3P.P$1
unnamed: ELECTRODE-CONNECTOR.13, IN4P.P$1
unnamed: ELECTRODE-CONNECTOR.15, IN5P.P$1
unnamed: ELECTRODE-CONNECTOR.17, IN6P.P$1
unnamed: ELECTRODE-CONNECTOR.19, IN7P.P$1
unnamed: ELECTRODE-CONNECTOR.21, IN8P.P$1
unnamed: JP1.1, R1.2
REF_ELEC: ELECTRODE-CONNECTOR.23, REF_ELEC.P$1, REF_ELEC_MULTIBOARD_CONNECTOR.1 (-), REF_ELEC_MULTIBOARD_CONNECTOR.2 (+)

Notes on the sheet:
Fiducials - Top
Fiducials - Bottom
v 1.0
v0.2
Copyright © 2019 Adam Feuer Released the CERN Open Hardware License v.1.2

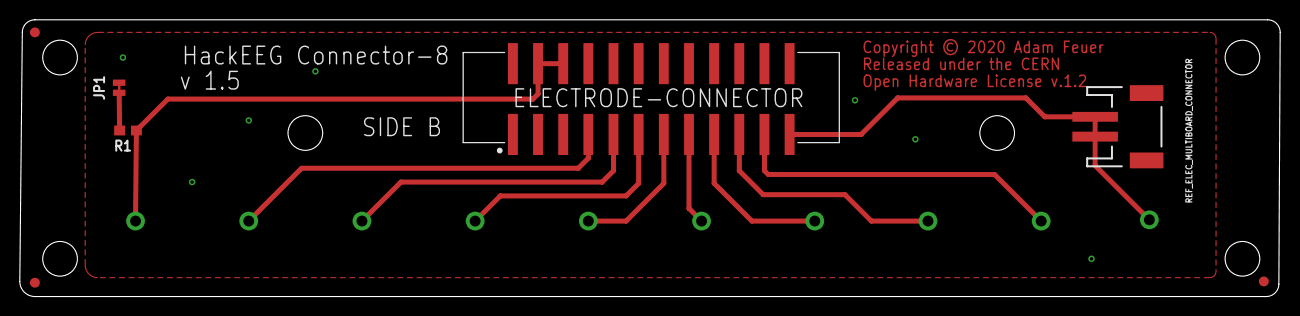
[picture p31: board hackeeg-connector-8-vertical.brd from above]

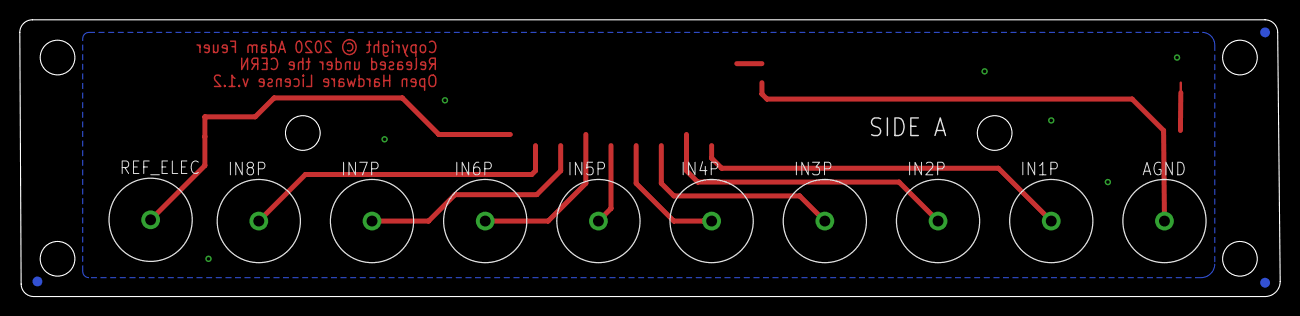
[picture p32: board hackeeg-connector-8-vertical.brd from below]

Board: 2 copper layers, 127.3 x 27.9 mm, 20 parts (13 on the bottom side), 12 nets.
