Hobbit13/hackeeg-shield/eagle - Copy/hackeeg-connector-8-horizontal.brd

## EAGLE design eagle - Copy/hackeeg-connector-8-horizontal.brd (2022-07-28, an earlier design)

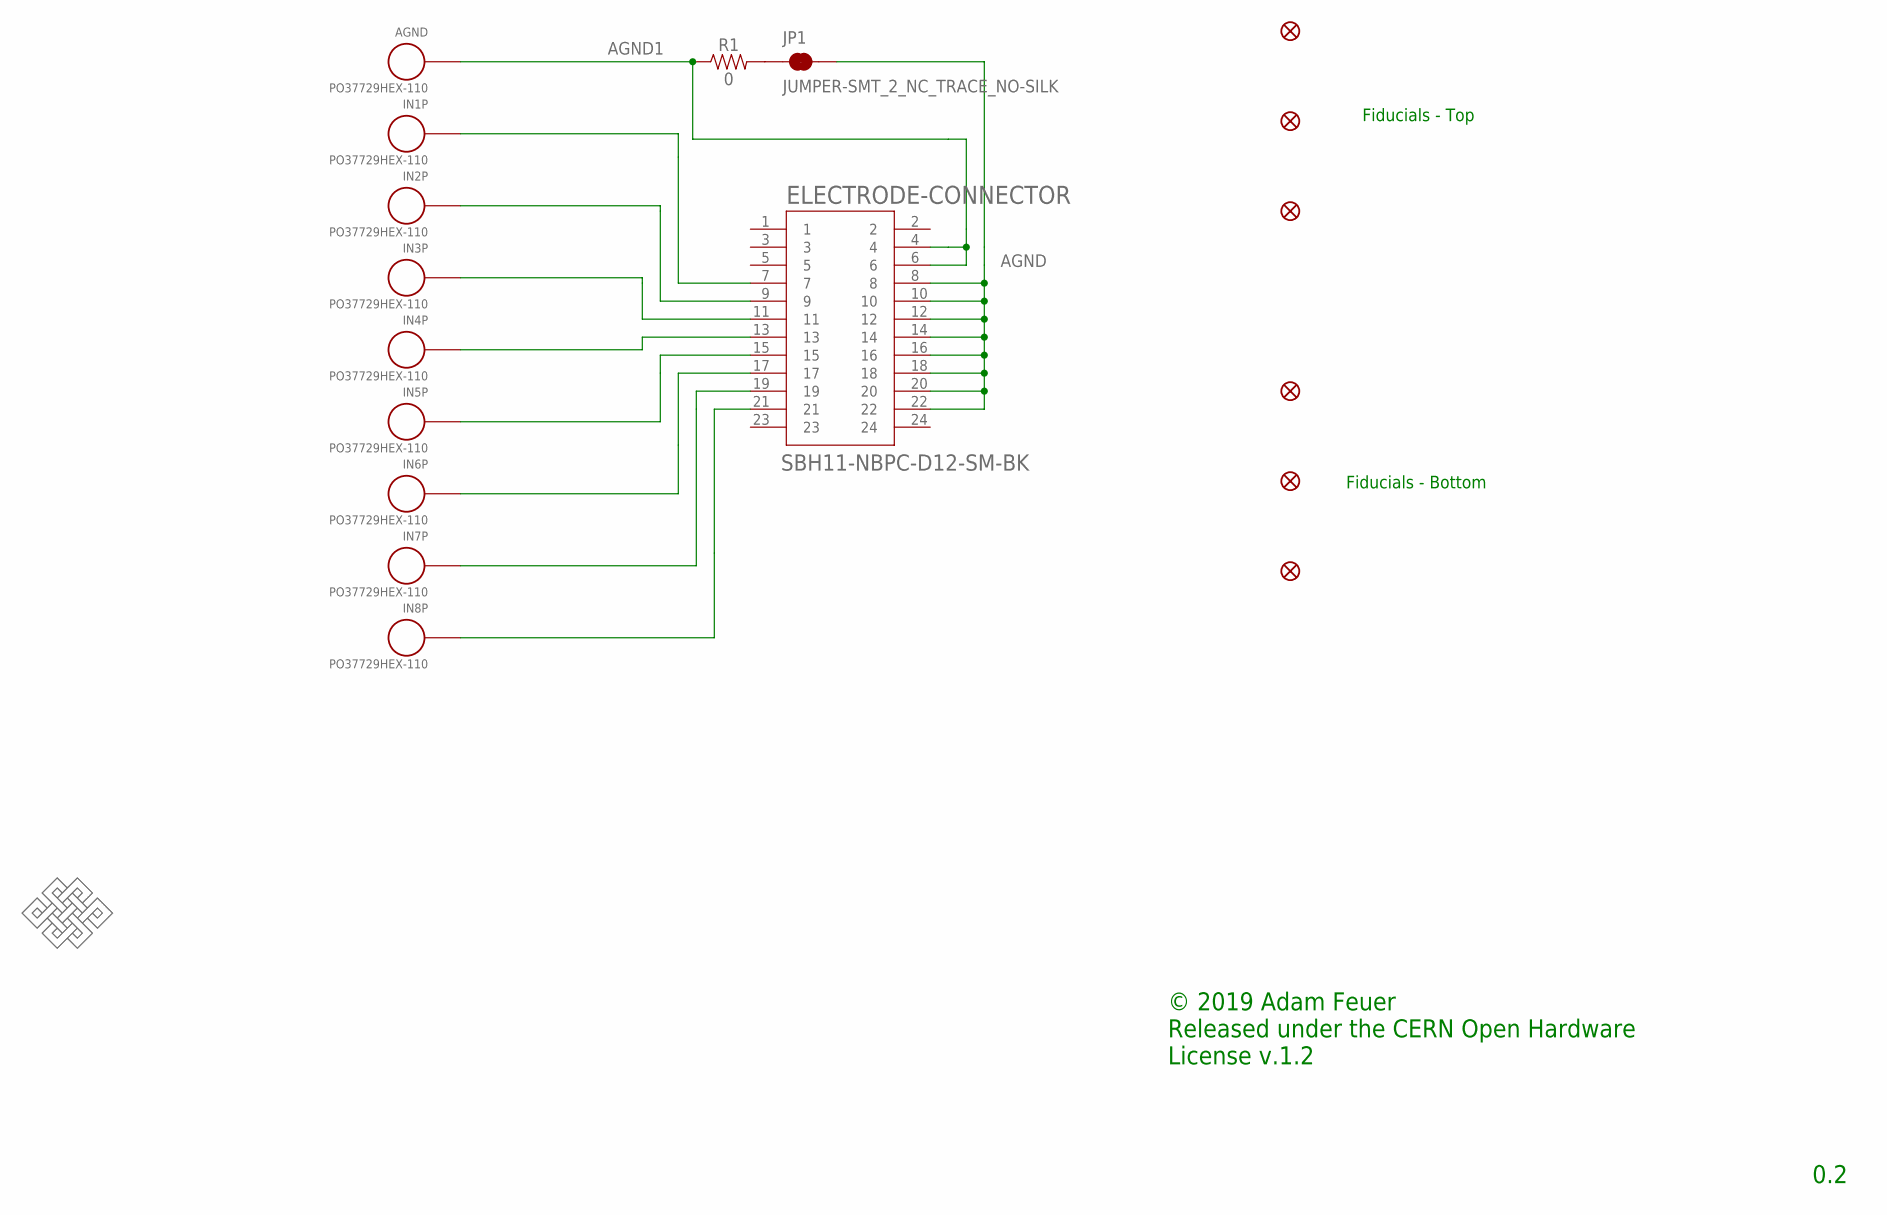
[picture p33: schematic hackeeg-connector-8-horizontal.sch, HACKEEG 8 Position Connector Board]

Parts:
AGND: PO37729HEX-110; HEX-110
ELECTRODE-CONNECTOR: SBH11-NBPC-D12-SM-BK; SULLINS_SBH11-NBPC-D12-SM-BK
FD1, FD2, FD3, FD4, FD5, FD6: FIDUCIAL1X2; FIDUCIAL-1X2
IN1P, IN2P, IN3P, IN4P, IN5P, IN6P, IN7P, IN8P: PO37729HEX-110; HEX-110
JP1: JUMPER-SMT_2_NC_TRACE_NO-SILK; SMT-JUMPER_2_NC_TRACE_NO-SILK
R1: 0; 0603
U$1: ENDLESSKNOTENDLESSKNOT-MEDIUM; ENDLESSKNOT-MEDIUM

Connections:
AGND: ELECTRODE-CONNECTOR.8, ELECTRODE-CONNECTOR.10, ELECTRODE-CONNECTOR.12, ELECTRODE-CONNECTOR.14, ELECTRODE-CONNECTOR.16, ELECTRODE-CONNECTOR.18, ELECTRODE-CONNECTOR.20, ELECTRODE-CONNECTOR.22, JP1.2
AGND1: AGND.SIGNAL, ELECTRODE-CONNECTOR.4, ELECTRODE-CONNECTOR.6, R1.1
unnamed: ELECTRODE-CONNECTOR.7, IN1P.SIGNAL
unnamed: ELECTRODE-CONNECTOR.9, IN2P.SIGNAL
unnamed: ELECTRODE-CONNECTOR.11, IN3P.SIGNAL
unnamed: ELECTRODE-CONNECTOR.13, IN4P.SIGNAL
unnamed: ELECTRODE-CONNECTOR.15, IN5P.SIGNAL
unnamed: ELECTRODE-CONNECTOR.17, IN6P.SIGNAL
unnamed: ELECTRODE-CONNECTOR.19, IN7P.SIGNAL
unnamed: ELECTRODE-CONNECTOR.21, IN8P.SIGNAL
unnamed: JP1.1, R1.2

Notes on the sheet:
Fiducials - Top
Fiducials - Bottom
© 2019 Adam Feuer Released under the CERN Open Hardware License v.1.2
0.2

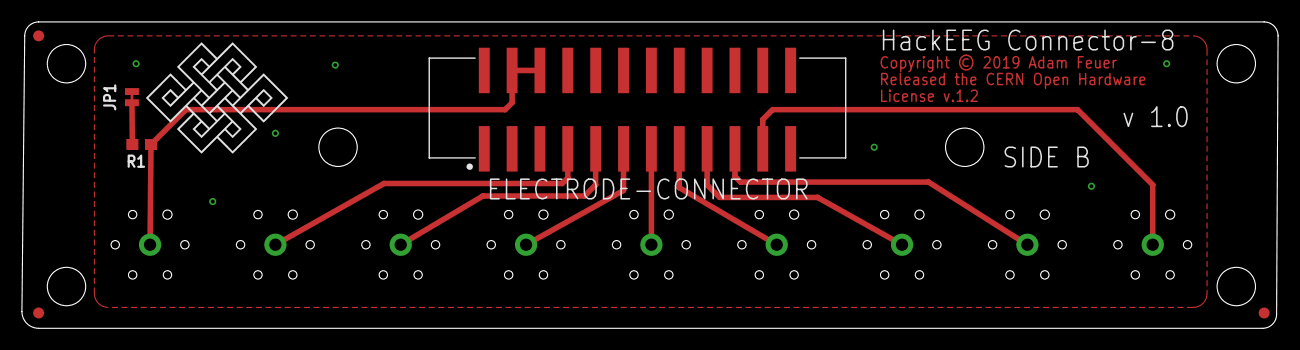
[picture p34: board hackeeg-connector-8-horizontal.brd from above]

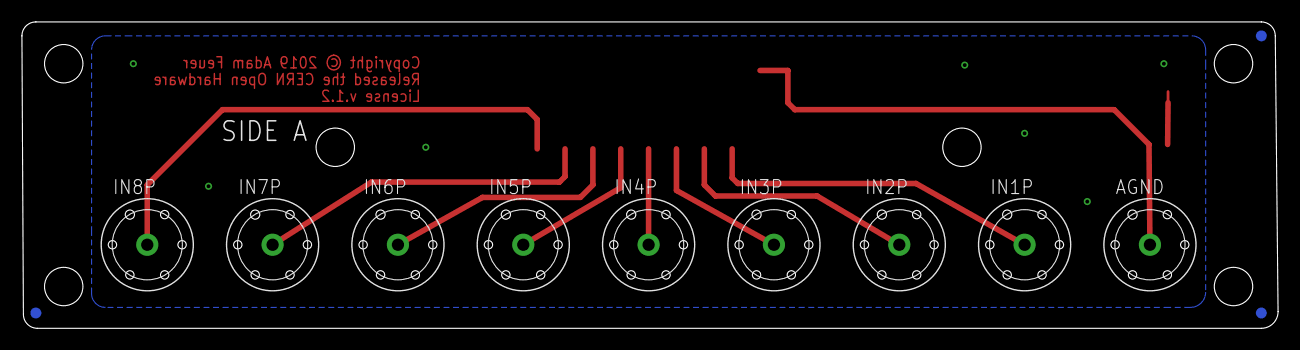
[picture p35: board hackeeg-connector-8-horizontal.brd from below]

Board: 2 copper layers, 114.6 x 27.9 mm, 19 parts (12 on the bottom side), 11 nets.
