Hobbit13/hackeeg-shield/eagle - Copy/hackeeg-shield.brd

## EAGLE design eagle - Copy/hackeeg-shield.brd (2022-07-28, an earlier design)

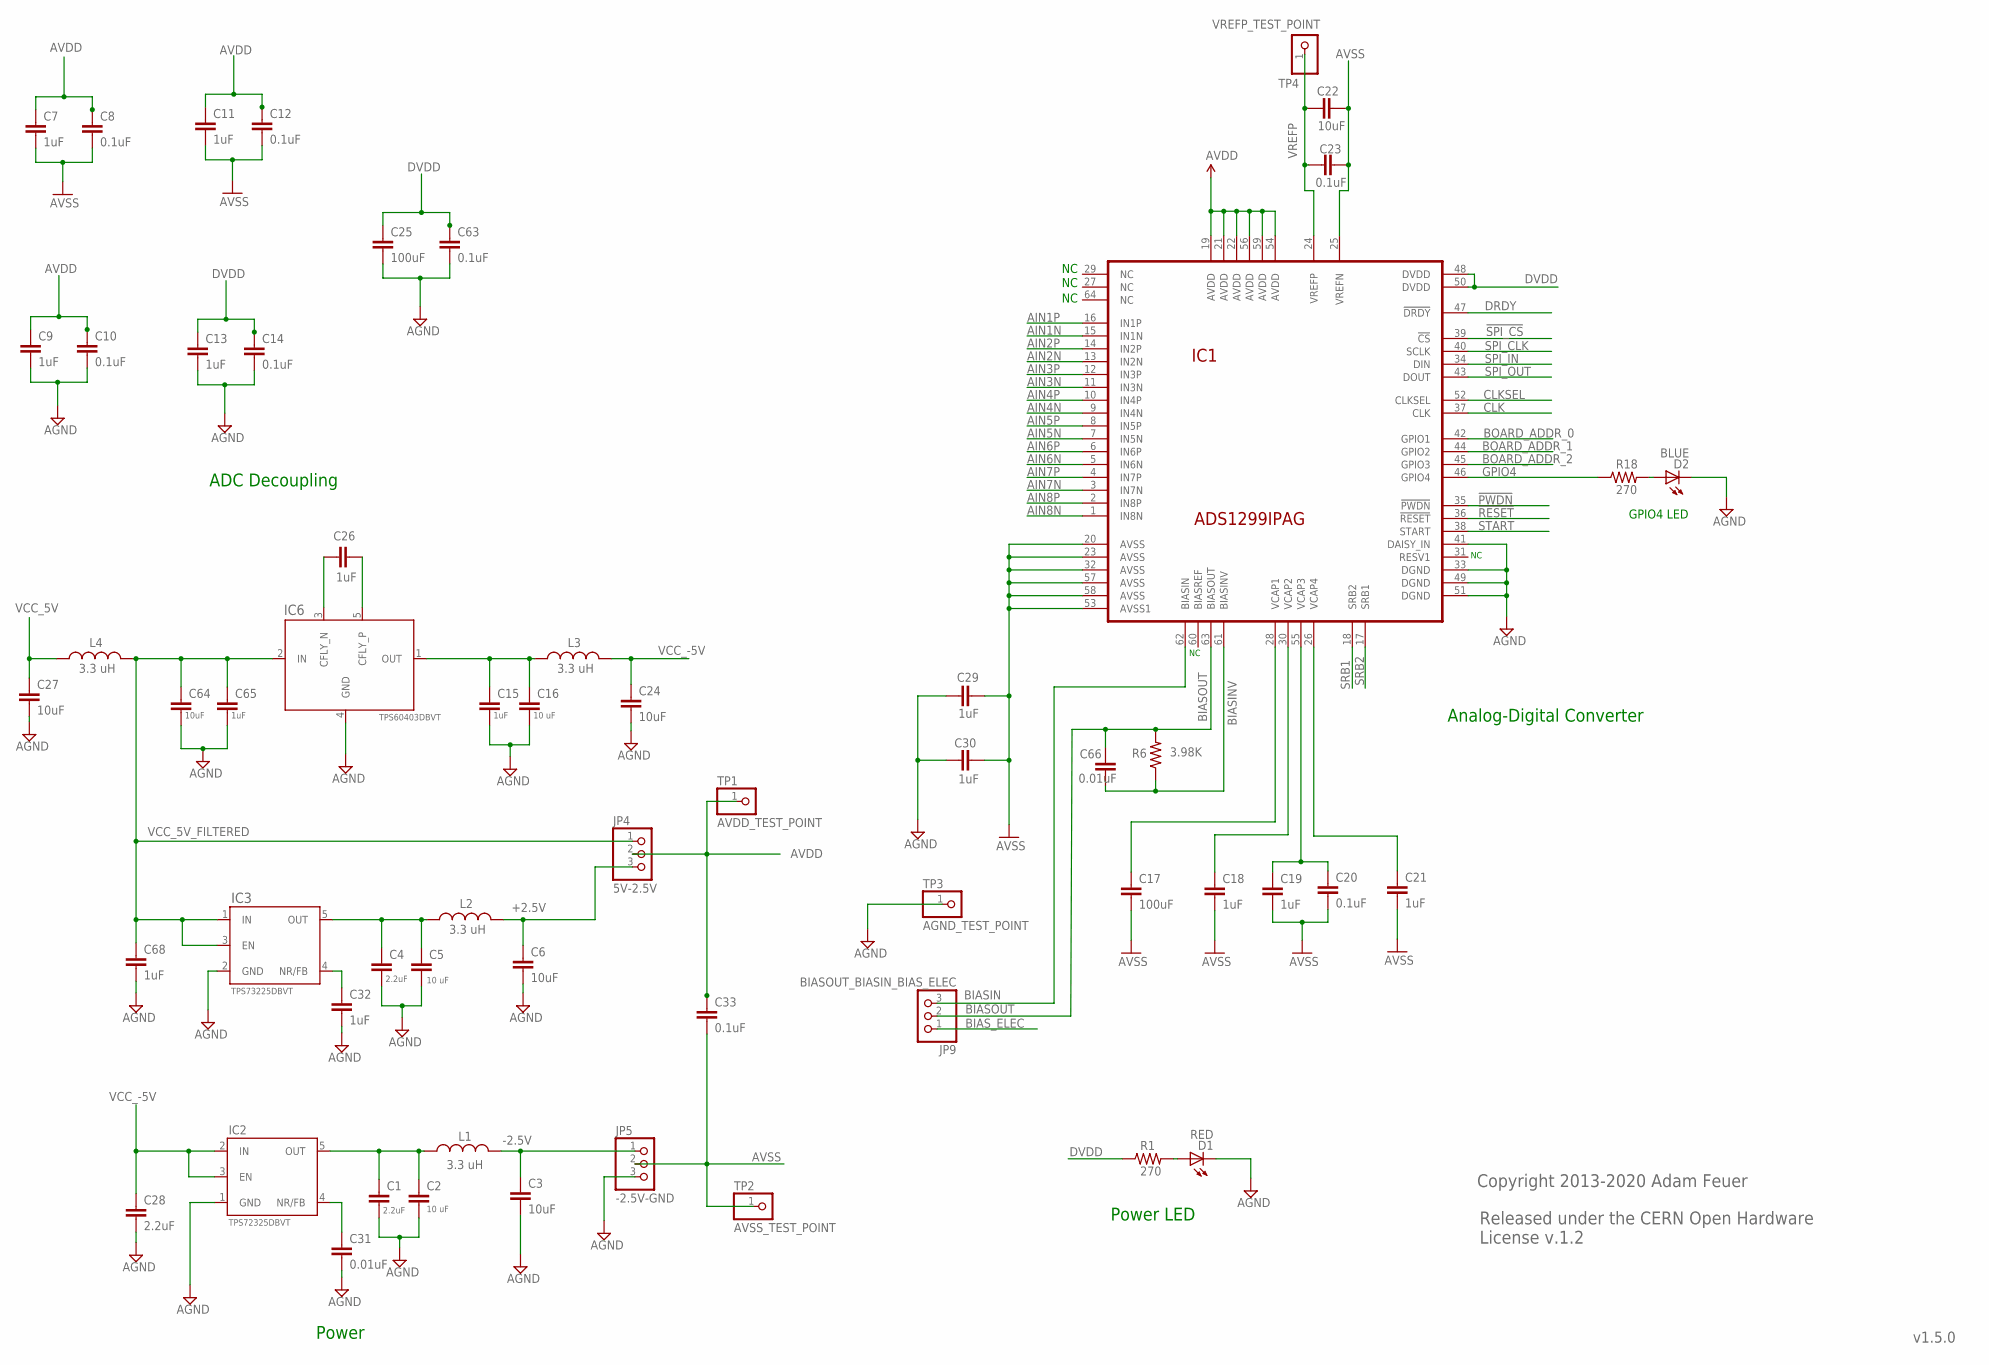
[picture p36: schematic hackeeg-shield.sch, sheet 1, ADS1299 and power supplies]

Parts:
C1, C4, C28: 2.2uF; 0603-CAP
C2, C5, C16: 10 uF; 0603-CAP
C3, C6, C22, C24, C27, C64: 10uF; 0603-CAP
C7, C9, C11, C13, C15, C18, C19, C21, C26, C29, C30, C32, C65, C68: 1uF; 0603-CAP
C8, C10, C12, C14, C20, C23, C33, C63: 0.1uF; 0603-CAP
C17, C25: 100uF; 1210
C31, C66: 0.01uF; 0603-CAP
D1: RED; LED-1206
D2: BLUE; LED-1206
IC1: ADS1299IPAG; TQFP64
IC2: TPS72325DBVT; SOT23-5
IC3: TPS73225DBVT; SOT23-5
IC6: TPS60403DBVT; SOT23-5
JP4: 5V-2.5V; 1X03
JP5: -2.5V-GND; 1X03
JP9: BIASOUT_BIASIN_BIAS_ELEC; 1X03
L1, L2, L3, L4: 3.3 uH; 0805
R1, R18: 270; 0603-RES
R6: 3.98K; 0603-RES
TP1: AVDD_TEST_POINT; 1X01
TP2: AVSS_TEST_POINT; 1X01
TP3: AGND_TEST_POINT; 1X01
TP4: VREFP_TEST_POINT; 1X01

Connections:
!PWDN: IC1.35 (!PWDN); also elsewhere on the board
!RESET: IC1.36 (!RESET); also elsewhere on the board
!SPI_CS: IC1.39 (!CS); also elsewhere on the board
+2.5V: C6.1, JP4.3, L2.2
-2.5V: C3.1, JP5.1, L1.2
AGND: C1.2, C2.2, C3.2, C4.2, C5.2, C6.2, C9.2, C10.2, C13.2, C14.2, C15.2, C16.2, C24.2, C25.2, C27.2, C28.2, C29.1, C30.1, C31.2, C32.2, C63.2, C64.2, C65.2, C68.2, D1.C, D2.C, IC1.33 (DGND), IC1.41 (DAISY_IN), IC1.49 (DGND), IC1.51 (DGND), IC2.1 (GND), IC3.2 (GND), IC6.4 (GND), JP5.3, TP3.1; also elsewhere on the board
AIN1N: IC1.15 (IN1N); also elsewhere on the board
AIN1P: IC1.16 (IN1P); also elsewhere on the board
AIN2N: IC1.13 (IN2N); also elsewhere on the board
AIN2P: IC1.14 (IN2P); also elsewhere on the board
AIN3N: IC1.11 (IN3N); also elsewhere on the board
AIN3P: IC1.12 (IN3P); also elsewhere on the board
AIN4N: IC1.9 (IN4N); also elsewhere on the board
AIN4P: IC1.10 (IN4P); also elsewhere on the board
AIN5N: IC1.7 (IN5N); also elsewhere on the board
AIN5P: IC1.8 (IN5P); also elsewhere on the board
AIN6N: IC1.5 (IN6N); also elsewhere on the board
AIN6P: IC1.6 (IN6P); also elsewhere on the board
AIN7N: IC1.3 (IN7N); also elsewhere on the board
AIN7P: IC1.4 (IN7P); also elsewhere on the board
AIN8N: IC1.1 (IN8N); also elsewhere on the board
AIN8P: IC1.2 (IN8P); also elsewhere on the board
AVDD: C7.1, C8.1, C9.1, C10.1, C11.1, C12.1, C33.1, IC1.19 (AVDD), IC1.21 (AVDD), IC1.22 (AVDD), IC1.54 (AVDD), IC1.56 (AVDD), IC1.59 (AVDD), JP4.2, TP1.1; also elsewhere on the board
AVSS: C7.2, C8.2, C11.2, C12.2, C17.2, C18.2, C19.2, C20.2, C21.2, C22.2, C23.2, C29.2, C30.2, C33.2, IC1.20 (AVSS), IC1.23 (AVSS), IC1.25 (VREFN), IC1.32 (AVSS), IC1.53 (AVSS1), IC1.57 (AVSS), IC1.58 (AVSS), JP5.2, TP2.1; also elsewhere on the board
BIASIN: IC1.62 (BIASIN), JP9.3
BIASINV: C66.2, IC1.61 (BIASINV), R6.1; also elsewhere on the board
BIASOUT: C66.1, IC1.63 (BIASOUT), JP9.2, R6.2
BIAS_ELEC: JP9.1; also elsewhere on the board
BOARD_ADDR_0: IC1.42 (GPIO1); also elsewhere on the board
BOARD_ADDR_1: IC1.44 (GPIO2); also elsewhere on the board
BOARD_ADDR_2: IC1.45 (GPIO3); also elsewhere on the board
CLK: IC1.37 (CLK); also elsewhere on the board
CLKSEL: IC1.52 (CLKSEL); also elsewhere on the board
DRDY: IC1.47 (!DRDY); also elsewhere on the board
DVDD: C13.1, C14.1, C25.1, C63.1, IC1.48 (DVDD), IC1.50 (DVDD), R1.1; also elsewhere on the board
GPIO4: IC1.46 (GPIO4), R18.1
unnamed: C4.1, C5.1, IC3.5 (OUT), L2.1
unnamed: C1.1, C2.1, IC2.5 (OUT), L1.1
unnamed: C17.1, IC1.28 (VCAP1)
unnamed: C18.1, IC1.30 (VCAP2)
unnamed: C19.1, C20.1, IC1.55 (VCAP3)
unnamed: C15.1, C16.1, IC6.1 (OUT), L3.1
unnamed: C21.1, IC1.26 (VCAP4)
unnamed: C26.2, IC6.5 (CFLY_P)
unnamed: C26.1, IC6.3 (CFLY_N)
unnamed: C32.1, IC3.4 (NR/FB)
unnamed: C31.1, IC2.4 (NR/FB)
unnamed: D2.A, R18.2
unnamed: D1.A, R1.2
SPI_CLK: IC1.40 (SCLK); also elsewhere on the board
SPI_IN: IC1.34 (DIN); also elsewhere on the board
SPI_OUT: IC1.43 (DOUT); also elsewhere on the board
SRB1: IC1.18 (SRB2); also elsewhere on the board
SRB2: IC1.17 (SRB1); also elsewhere on the board
START: IC1.38 (START); also elsewhere on the board
VCC_5V: C27.1, L4.1; also elsewhere on the board
VCC_5V_FILTERED: C64.1, C65.1, C68.1, IC3.1 (IN), IC3.3 (EN), IC6.2 (IN), JP4.1, L4.2
VCC_-5V: C24.1, C28.1, IC2.2 (IN), IC2.3 (EN), L3.2
VREFP: C22.1, C23.1, IC1.24 (VREFP), TP4.1

Notes on the sheet:
Released under the CERN Open Hardware License v.1.2
Copyright 2013-2020 Adam Feuer
v1.5.0
ADC Decoupling
Power
Analog-Digital Converter
GPIO4 LED
Power LED

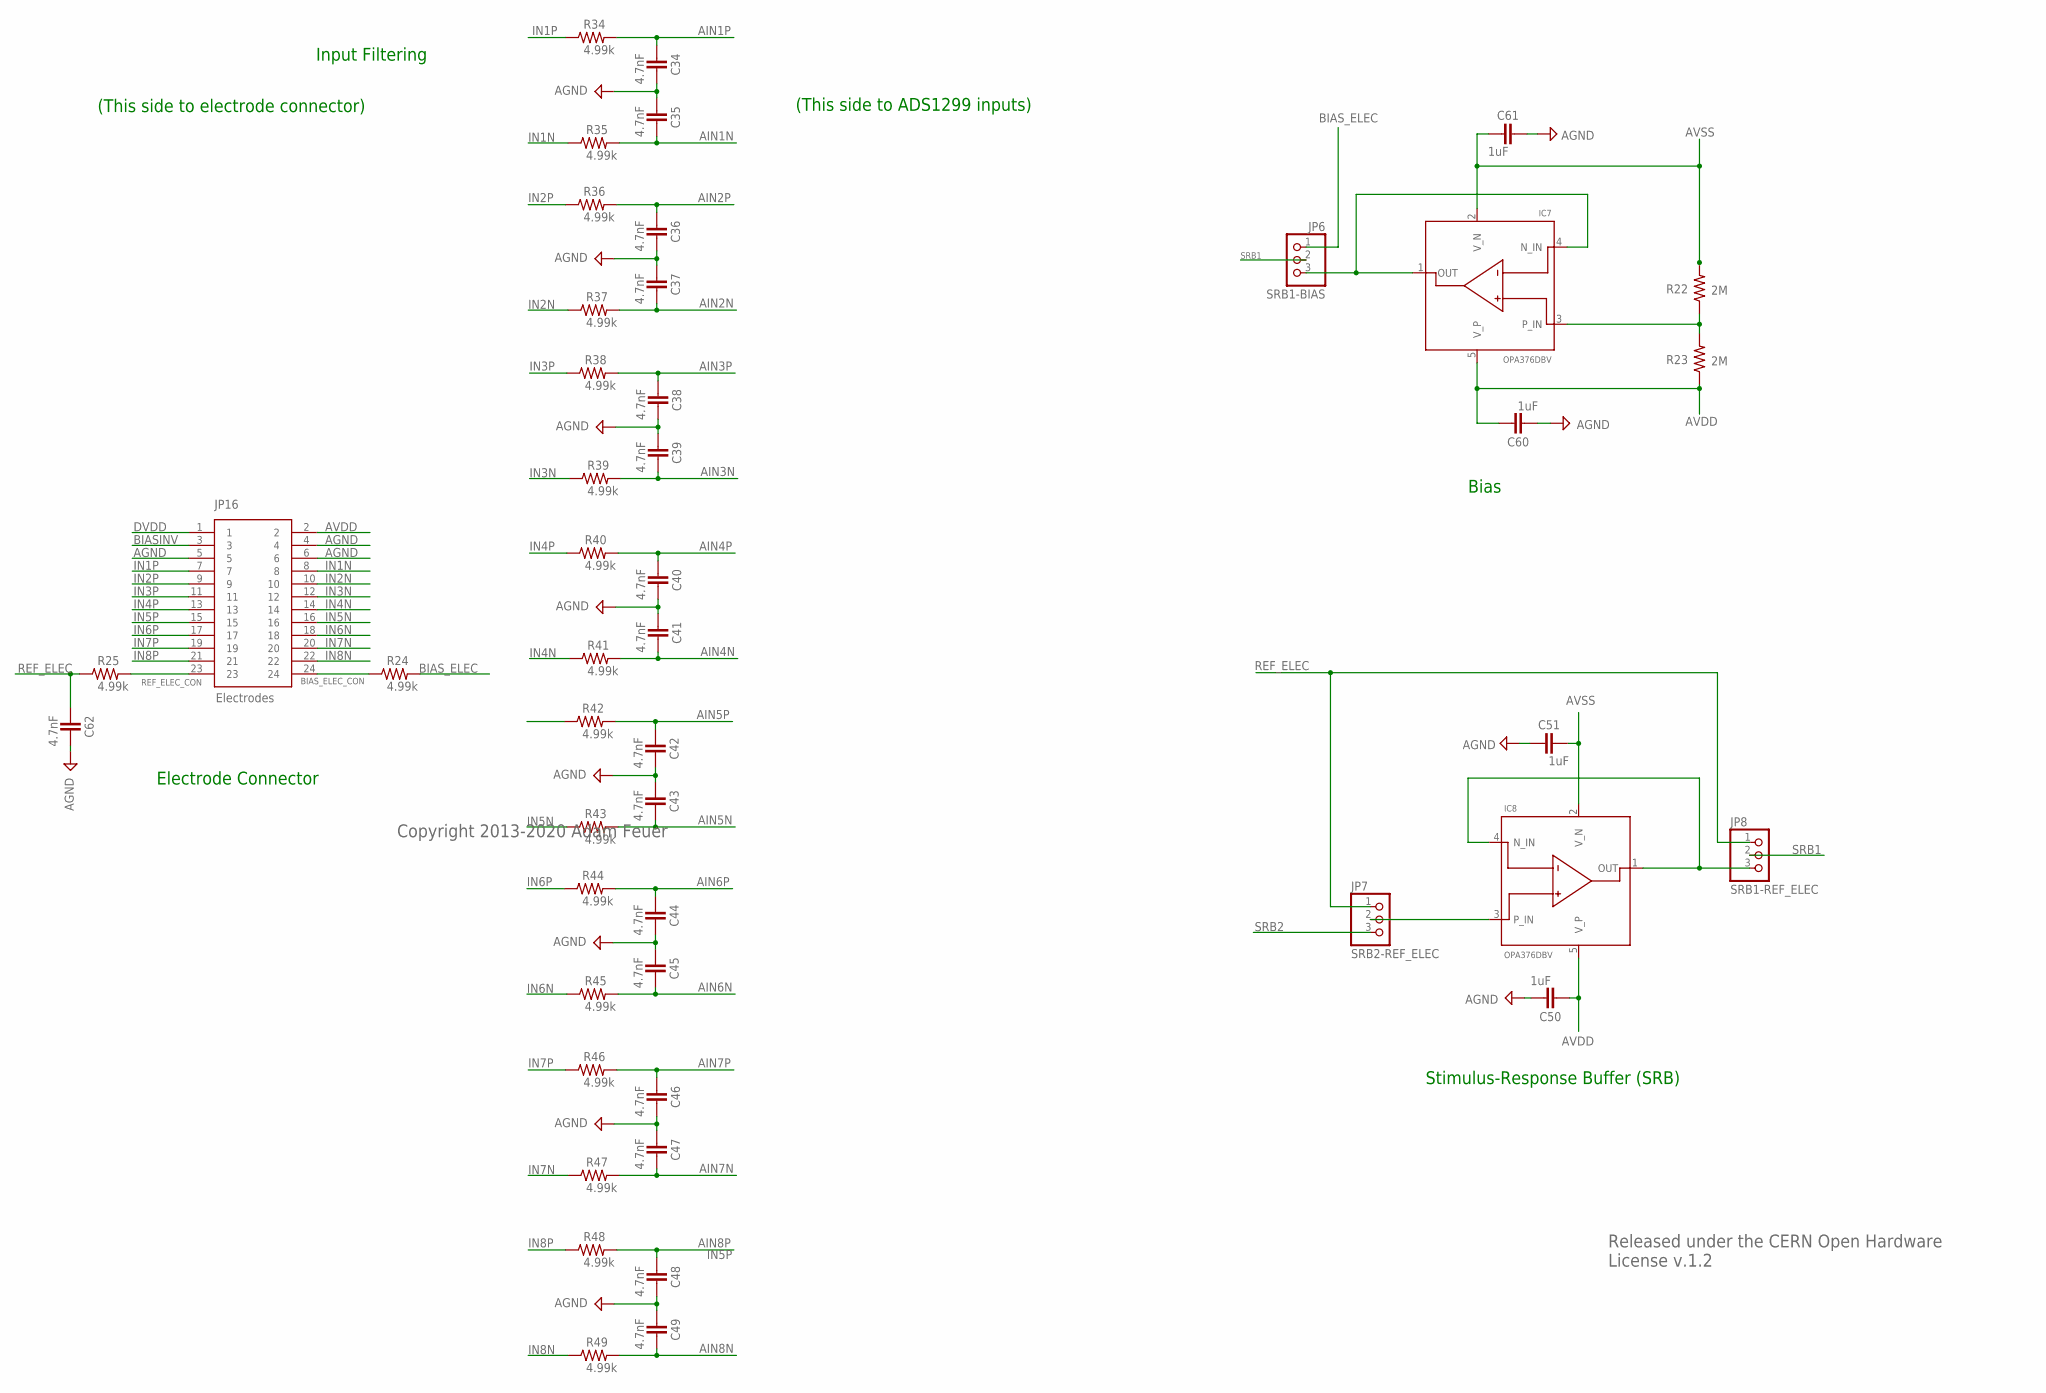
[picture p37: schematic hackeeg-shield.sch, sheet 2, Input filtering and electrode connector]

Parts:
C34, C35, C36, C37, C38, C39, C40, C41, C42, C43, C44, C45, C46, C47, C48, C49, C62: 4.7nF; 0603-CAP
C50, C51, C60, C61: 1uF; 0603-CAP
IC7, IC8: OPA376DBV; SOT23-5
JP6: SRB1-BIAS; 1X03
JP7: SRB2-REF_ELEC; 1X03
JP8: SRB1-REF_ELEC; 1X03
JP16: Electrodes; OST_302-R241
R22, R23: 2M; 0603-RES
R24, R25, R34, R35, R36, R37, R38, R39, R40, R41, R42, R43, R44, R45, R46, R47, R48, R49: 4.99k; 0603-RES

Connections:
AGND: C34.2, C35.1, C36.2, C37.1, C38.2, C39.1, C40.2, C41.1, C42.2, C43.1, C44.2, C45.1, C46.2, C47.1, C48.2, C49.1, C50.2, C51.1, C60.2, C61.1, C62.2, JP16.4, JP16.5, JP16.6; also elsewhere on the board
AIN1N: C35.2, R35.2; also elsewhere on the board
AIN1P: C34.1, R34.2; also elsewhere on the board
AIN2N: C37.2, R37.2; also elsewhere on the board
AIN2P: C36.1, R36.2; also elsewhere on the board
AIN3N: C39.2, R39.2; also elsewhere on the board
AIN3P: C38.1, R38.2; also elsewhere on the board
AIN4N: C41.2, R41.2; also elsewhere on the board
AIN4P: C40.1, R40.2; also elsewhere on the board
AIN5N: C43.2, R43.2; also elsewhere on the board
AIN5P: C42.1, R42.2; also elsewhere on the board
AIN6N: C45.2, R45.2; also elsewhere on the board
AIN6P: C44.1, R44.2; also elsewhere on the board
AIN7N: C47.2, R47.2; also elsewhere on the board
AIN7P: C46.1, R46.2; also elsewhere on the board
AIN8N: C49.2, R49.2; also elsewhere on the board
AIN8P: C48.1, R48.2; also elsewhere on the board
AVDD: C50.1, C60.1, IC7.5 (V_P), IC8.5 (V_P), JP16.2, R23.1; also elsewhere on the board
AVSS: C51.2, C61.2, IC7.2 (V_N), IC8.2 (V_N), R22.2; also elsewhere on the board
BIASINV: JP16.3; also elsewhere on the board
BIAS_ELEC: JP6.1, R24.2; also elsewhere on the board
BIAS_ELEC_CON: JP16.24, R24.1
DVDD: JP16.1; also elsewhere on the board
IN1N: JP16.8, R35.1
IN1P: JP16.7, R34.1
IN2N: JP16.10, R37.1
IN2P: JP16.9, R36.1
IN3N: JP16.12, R39.1
IN3P: JP16.11, R38.1
IN4N: JP16.14, R41.1
IN4P: JP16.13, R40.1
IN5N: JP16.16, R43.1
IN5P: JP16.15, R42.1
IN6N: JP16.18, R45.1
IN6P: JP16.17, R44.1
IN7N: JP16.20, R47.1
IN7P: JP16.19, R46.1
IN8N: JP16.22, R49.1
IN8P: JP16.21, R48.1
unnamed: IC7.3 (P_IN), R22.1, R23.2
unnamed: IC8.3 (P_IN), JP7.2
unnamed: IC8.1 (OUT), IC8.4 (N_IN), JP8.3
unnamed: IC7.1 (OUT), IC7.4 (N_IN), JP6.3
REF_ELEC: C62.1, JP7.1, JP8.1, R25.1
REF_ELEC_CON: JP16.23, R25.2
SRB1: JP6.2, JP8.2; also elsewhere on the board
SRB2: JP7.3; also elsewhere on the board

Notes on the sheet:
Electrode Connector
Stimulus-Response Buffer (SRB)
Bias
Released under the CERN Open Hardware License v.1.2
Copyright 2013-2020 Adam Feuer
Input Filtering
(This side to ADS1299 inputs)
(This side to electrode connector)

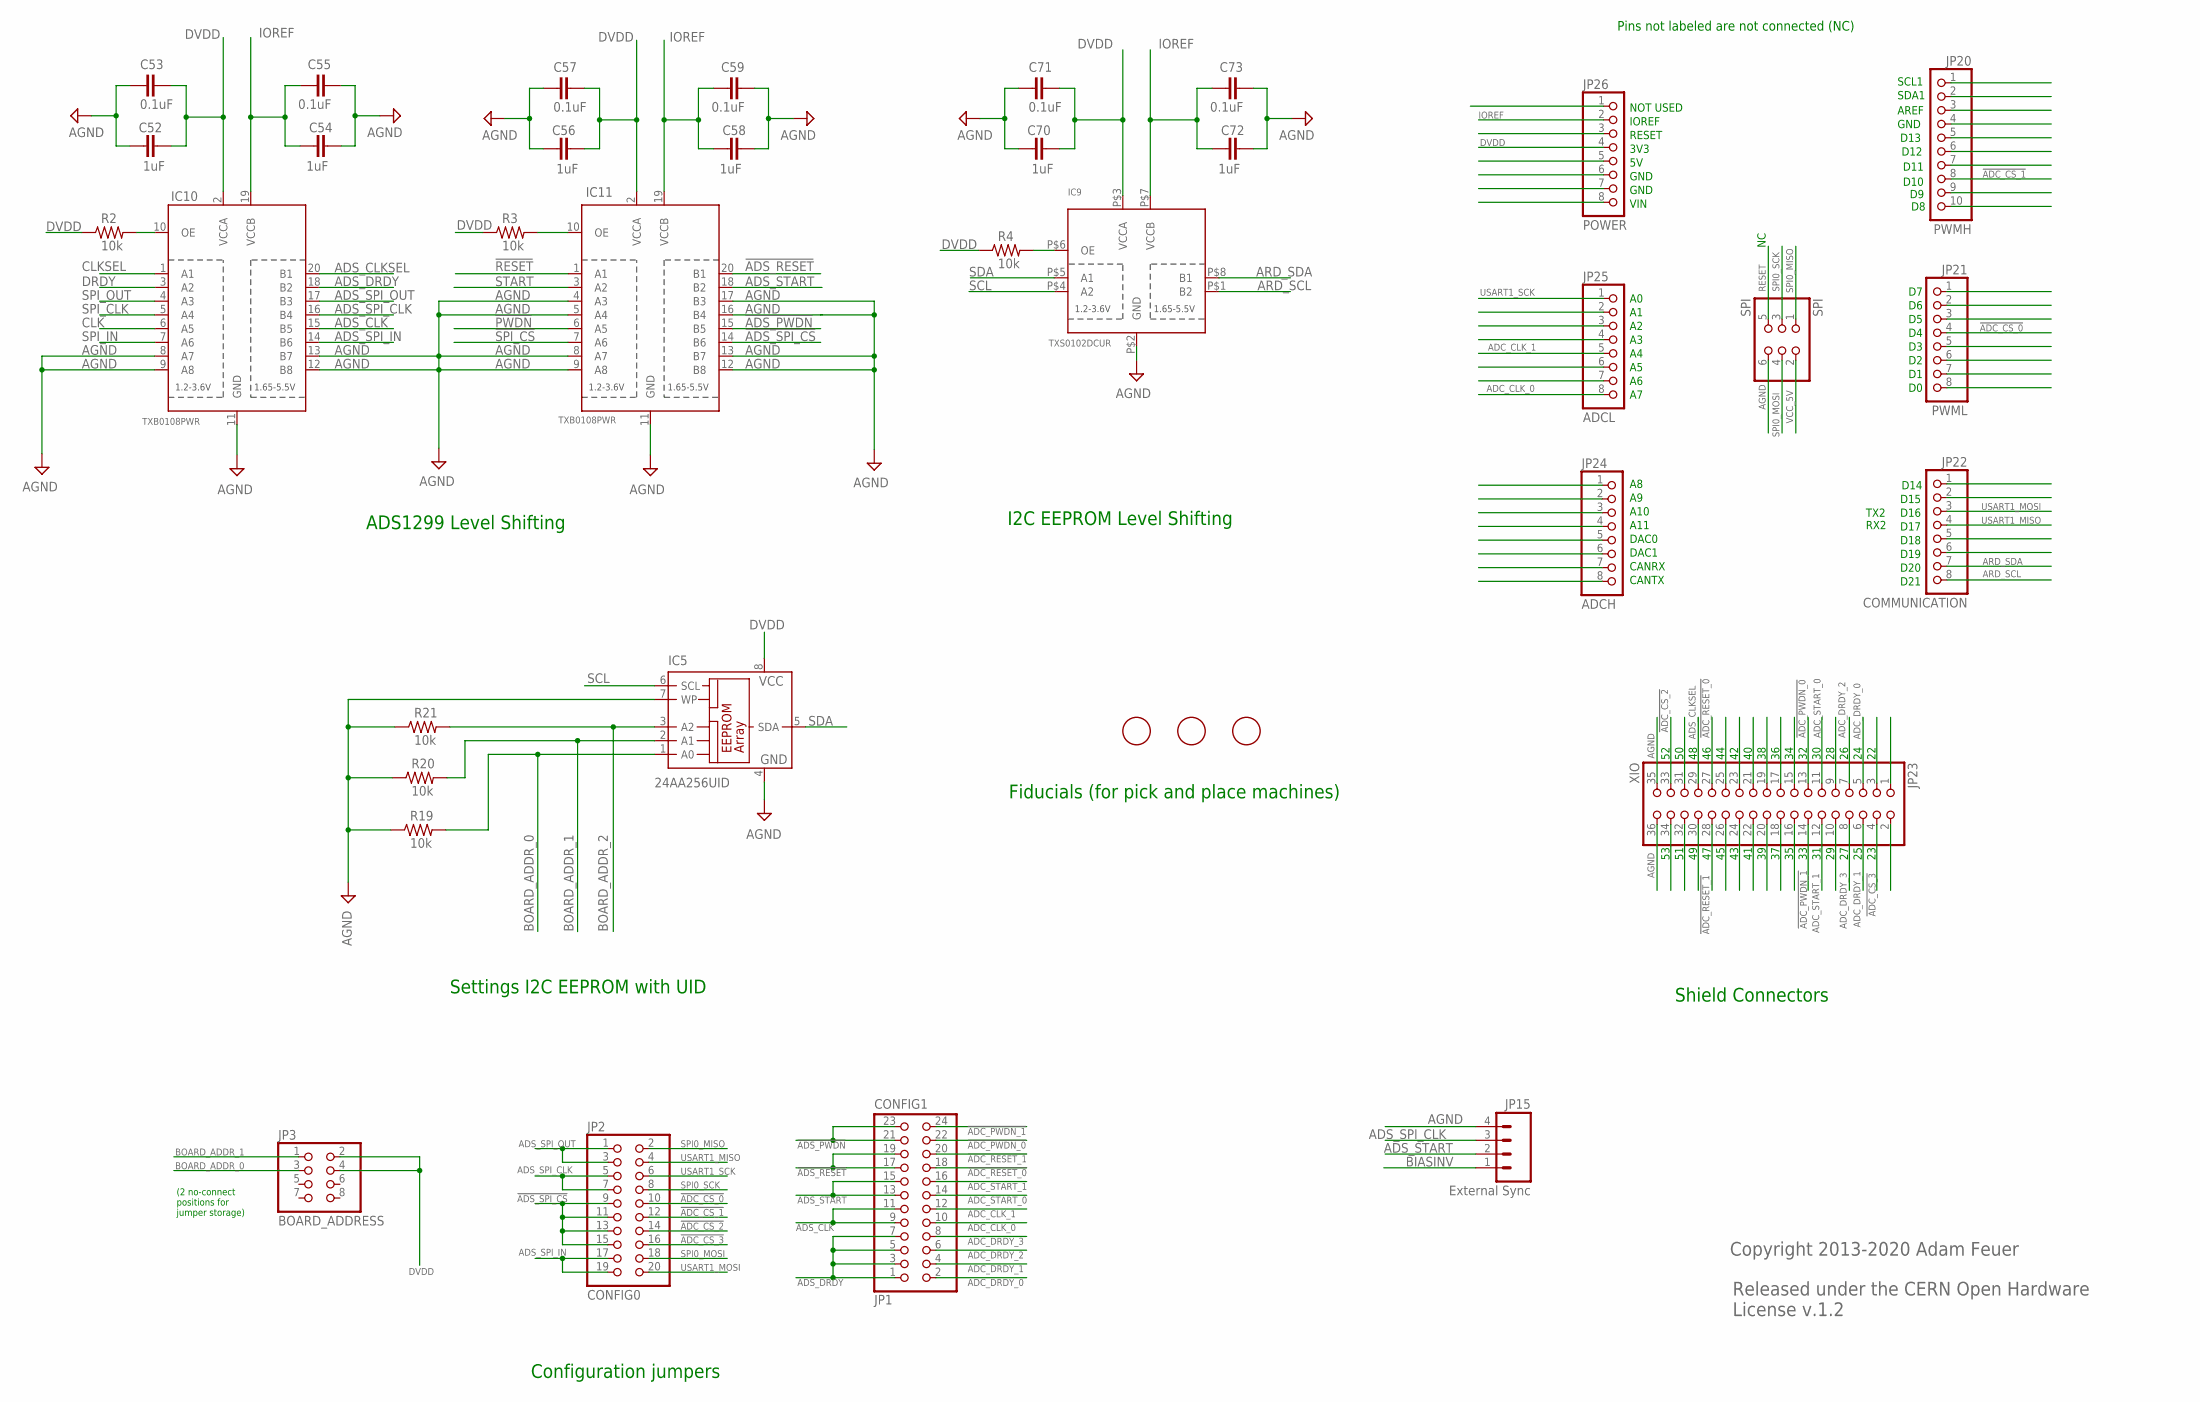
[picture p38: schematic hackeeg-shield.sch, sheet 3, Board to board connectors, configuration, EEPROM, and level…]

Parts:
C52, C54, C56, C58, C70, C72: 1uF; 0603-CAP
C53, C55, C57, C59, C71, C73: 0.1uF; 0603-CAP
IC5: 24AA256UID; SO-08
IC9: TXS0102DCUR; VFSOP-8
IC10, IC11: TXB0108PWR; TSSOP20
JP1: CONFIG1; 2X12
JP2: CONFIG0; 2X10
JP3: BOARD_ADDRESS; 2X04
JP15: External Sync; JST-4-PTH
JP20: PWMH; 1X10
JP21: PWML; 1X08
JP22: COMMUNICATION; 1X08
JP23: XIO; 2X18
JP24: ADCH; 1X08
JP25: ADCL; 1X08
JP26: POWER; 1X08
R2, R3, R4, R19, R20, R21: 10k; 0603-RES
SPI: SPI; 2X03
U$2, U$5, U$6: FIDUCIAL; FIDUCIAL_1MM

Connections:
!ADC_CS_0: JP2.10, JP21.4
!ADC_CS_1: JP2.12, JP20.8
!ADC_CS_2: JP2.14, JP23.33
!ADC_CS_3: JP2.16, JP23.4
!ADC_PWDN_0: JP1.22, JP23.13
!ADC_PWDN_1: JP1.24, JP23.14
!ADC_RESET_0: JP1.18, JP23.27
!ADC_RESET_1: JP1.20, JP23.28
!ADS_PWDN: IC11.15 (B5), JP1.21, JP1.23
!ADS_RESET: IC11.20 (B1), JP1.17, JP1.19
!ADS_SPI_CS: IC11.14 (B6), JP2.9, JP2.11, JP2.13, JP2.15
!PWDN: IC11.6 (A5); also elsewhere on the board
!RESET: IC11.1 (A1); also elsewhere on the board
!SPI_CS: IC11.7 (A6); also elsewhere on the board
ADC_CLK_0: JP1.10, JP25.8
ADC_CLK_1: JP1.12, JP25.5
ADC_DRDY_0: JP1.2, JP23.5
ADC_DRDY_1: JP1.4, JP23.6
ADC_DRDY_2: JP1.6, JP23.7
ADC_DRDY_3: JP1.8, JP23.8
ADC_START_0: JP1.14, JP23.11
ADC_START_1: JP1.16, JP23.12
ADS_CLK: IC10.15 (B5), JP1.9, JP1.11
ADS_CLKSEL: IC10.20 (B1), JP23.29
ADS_DRDY: IC10.18 (B2), JP1.1, JP1.3, JP1.5, JP1.7
ADS_SPI_CLK: IC10.16 (B4), JP2.5, JP2.7, JP15.3
ADS_SPI_IN: IC10.14 (B6), JP2.17, JP2.19
ADS_SPI_OUT: IC10.17 (B3), JP2.1, JP2.3
ADS_START: IC11.18 (B2), JP1.13, JP1.15, JP15.2
AGND: C52.1, C53.1, C54.1, C55.1, C56.1, C57.1, C58.1, C59.1, C70.1, C71.1, C72.1, C73.1, IC5.4 (GND), IC5.7 (WP), IC9.P$2 (GND), IC10.8 (A7), IC10.9 (A8), IC10.11 (GND), IC10.12 (B8), IC10.13 (B7), IC11.4 (A3), IC11.5 (A4), IC11.8 (A7), IC11.9 (A8), IC11.11 (GND), IC11.12 (B8), IC11.13 (B7), IC11.16 (B4), IC11.17 (B3), JP15.4, JP23.35, JP23.36, R19.1, R20.1, R21.1, SPI.6; also elsewhere on the board
ARD_SCL: IC9.P$1 (B2), JP22.8
ARD_SDA: IC9.P$8 (B1), JP22.7
BIASINV: JP15.1; also elsewhere on the board
BOARD_ADDR_0: IC5.1 (A0), JP3.3, R19.2; also elsewhere on the board
BOARD_ADDR_1: IC5.2 (A1), JP3.1, R20.2; also elsewhere on the board
BOARD_ADDR_2: IC5.3 (A2), R21.2; also elsewhere on the board
CLK: IC10.6 (A5); also elsewhere on the board
CLKSEL: IC10.1 (A1); also elsewhere on the board
DRDY: IC10.3 (A2); also elsewhere on the board
DVDD: C52.2, C53.2, C56.2, C57.2, C70.2, C71.2, IC5.8 (VCC), IC9.P$3 (VCCA), IC10.2 (VCCA), IC11.2 (VCCA), JP3.2, JP3.4, JP26.4, R2.1, R3.1, R4.1; also elsewhere on the board
IOREF: C54.2, C55.2, C58.2, C59.2, C72.2, C73.2, IC9.P$7 (VCCB), IC10.19 (VCCB), IC11.19 (VCCB), JP26.2
unnamed: IC9.P$6 (OE), R4.2
unnamed: IC10.10 (OE), R2.2
unnamed: IC11.10 (OE), R3.2
RESET: SPI.5
SCL: IC5.6 (SCL), IC9.P$4 (A2)
SDA: IC5.5 (SDA), IC9.P$5 (A1)
SPI0_MISO: JP2.2, SPI.1
SPI0_MOSI: JP2.18, SPI.4
SPI0_SCK: JP2.8, SPI.3
SPI_CLK: IC10.5 (A4); also elsewhere on the board
SPI_IN: IC10.7 (A6); also elsewhere on the board
SPI_OUT: IC10.4 (A3); also elsewhere on the board
START: IC11.3 (A2); also elsewhere on the board
USART1_MISO: JP2.4, JP22.4
USART1_MOSI: JP2.20, JP22.3
USART1_SCK: JP2.6, JP25.1
VCC_5V: SPI.2; also elsewhere on the board

Notes on the sheet:
Configuration jumpers
ADS1299 Level Shifting
Settings I2C EEPROM with UID
(2 no-connect positions for jumper storage)
Released under the CERN Open Hardware License v.1.2
Copyright 2013-2020 Adam Feuer
Shield Connectors
SCL1
SDA1
AREF
GND
D14
D15
D16
D17
D18
D19
D20
D21
A10
A11
DAC0
DAC1
CANRX
CANTX
NOT USED
IOREF
RESET
3V3
VIN
Fiducials (for pick and place machines)
TX2
RX2
I2C EEPROM Level Shifting
Pins not labeled are not connected (NC)
D13
D12
D11
D10

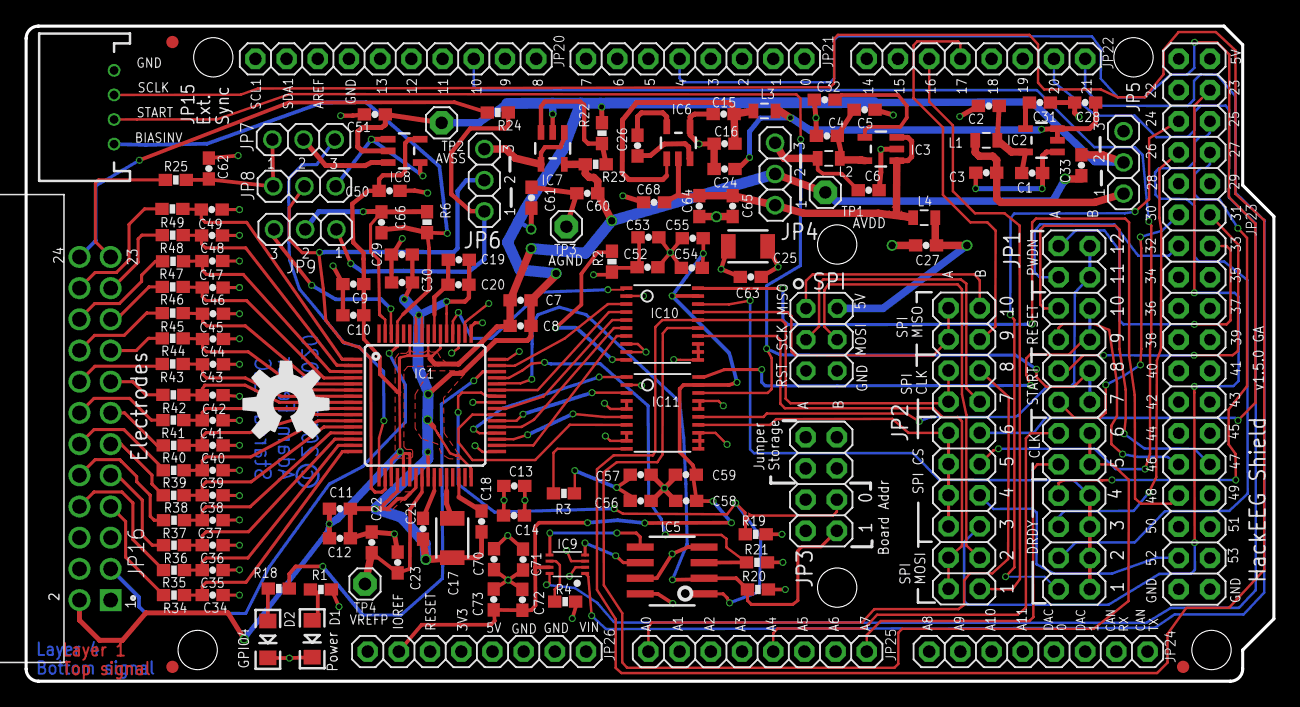
[picture p39: board eagle - Copy/hackeeg-shield.brd from above]

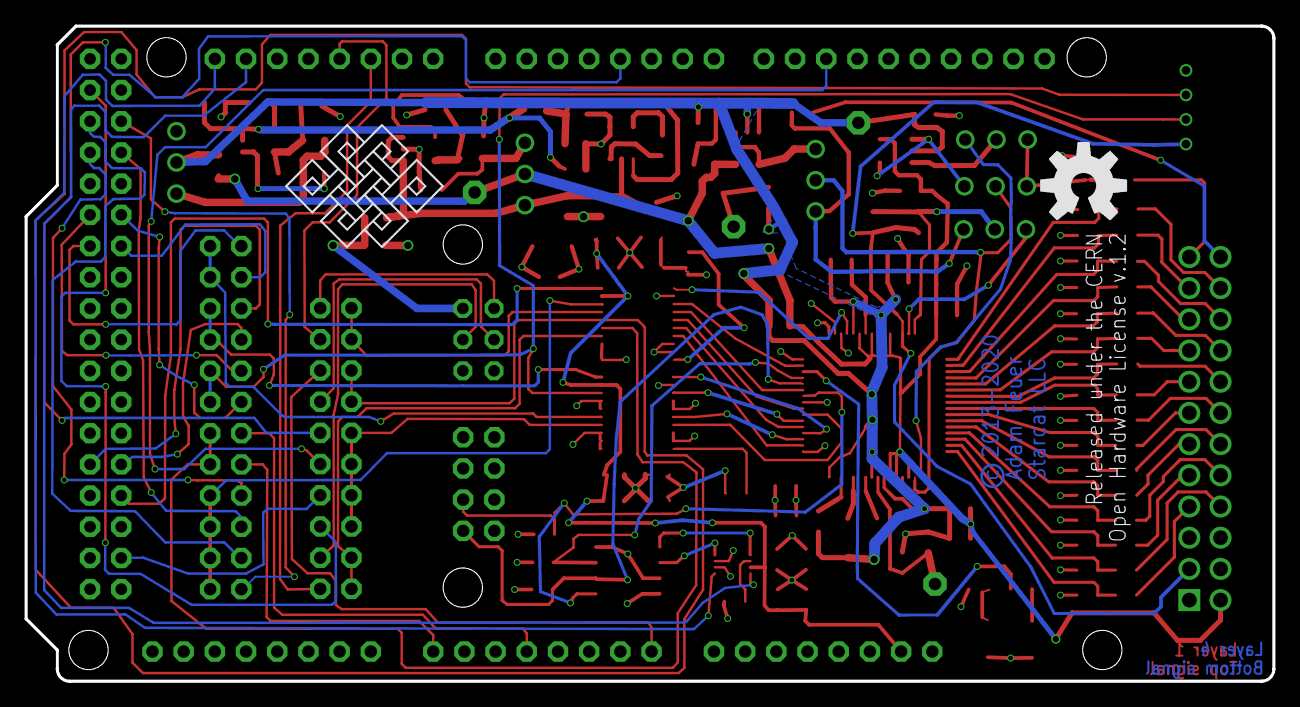
[picture p40: board eagle - Copy/hackeeg-shield.brd from below]

Board: 4 copper layers, 101.6 x 53.3 mm, 145 parts (2 on the bottom side), 122 nets.

Other parts of the board:
U$1, U$4: OSHW-LOGO-L
U$7: ENDLESSKNOT-MEDIUM
