Hobbit13/hackeeg-shield/eagle - Copy/hackeeg-connector-12.brd

## EAGLE design eagle - Copy/hackeeg-connector-12.brd (2022-07-28, an earlier design)

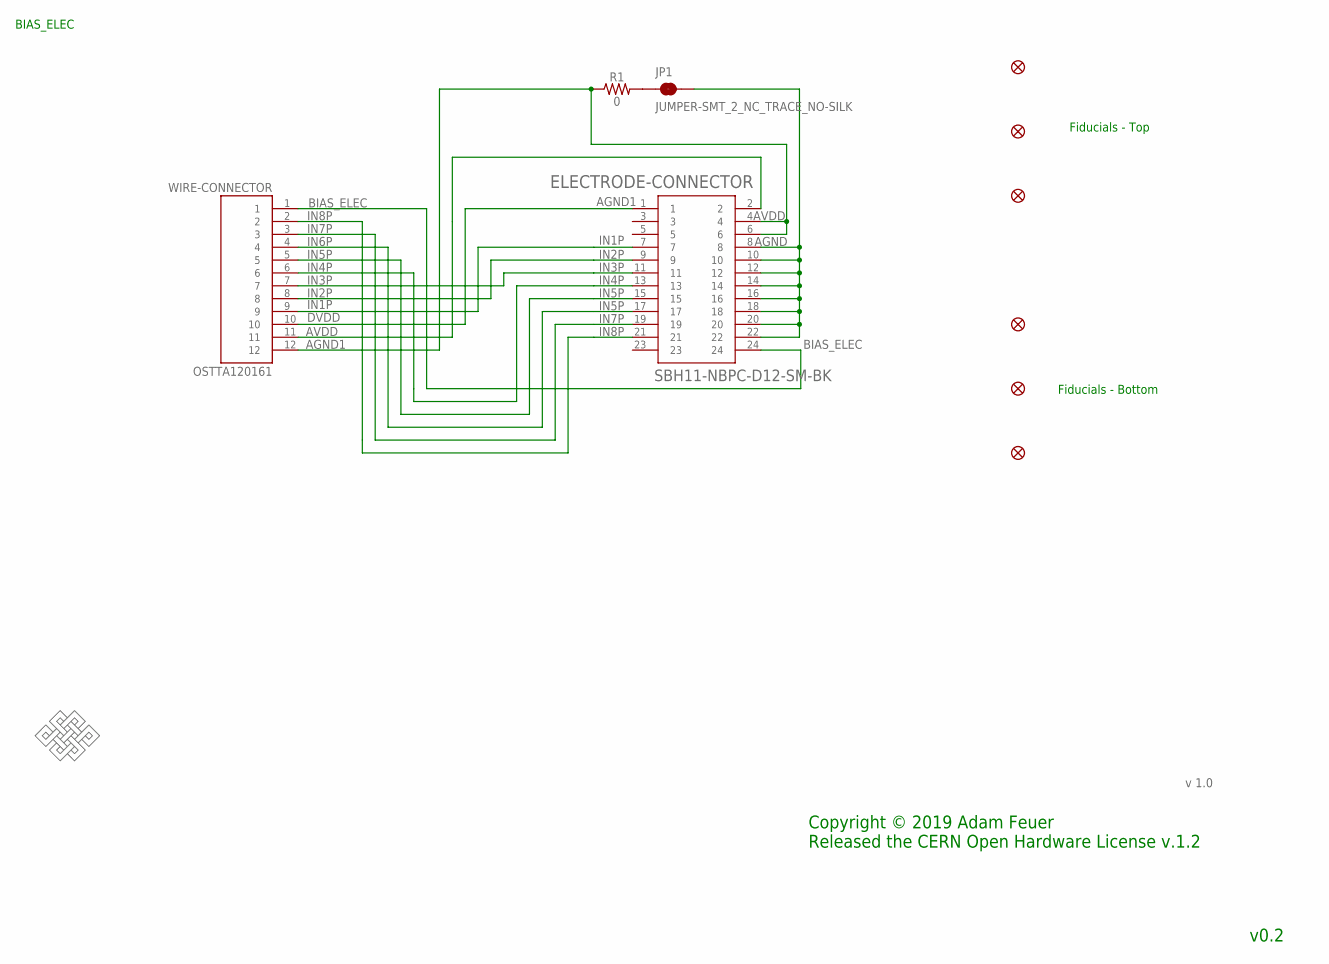
[picture p41: schematic hackeeg-connector-12.sch, HACKEEG 8 Position Connector Board]

Parts:
ELECTRODE-CONNECTOR: SBH11-NBPC-D12-SM-BK; SULLINS_SBH11-NBPC-D12-SM-BK
FD1, FD2, FD3, FD4, FD5, FD6: FIDUCIAL1X2; FIDUCIAL-1X2
JP1: JUMPER-SMT_2_NC_TRACE_NO-SILK; SMT-JUMPER_2_NC_TRACE_NO-SILK
R1: 0; 0603
U$1: ENDLESSKNOTENDLESSKNOT-MEDIUM; ENDLESSKNOT-MEDIUM
WIRE-CONNECTOR: OSTTA120161; ONSHORE_OSTTA120161

Connections:
AGND: ELECTRODE-CONNECTOR.8, ELECTRODE-CONNECTOR.10, ELECTRODE-CONNECTOR.12, ELECTRODE-CONNECTOR.14, ELECTRODE-CONNECTOR.16, ELECTRODE-CONNECTOR.18, ELECTRODE-CONNECTOR.20, ELECTRODE-CONNECTOR.22, JP1.2
AGND1: ELECTRODE-CONNECTOR.4, ELECTRODE-CONNECTOR.6, R1.1, WIRE-CONNECTOR.12
AVDD: ELECTRODE-CONNECTOR.2, WIRE-CONNECTOR.11
BIAS_ELEC: ELECTRODE-CONNECTOR.24, WIRE-CONNECTOR.1
DVDD: ELECTRODE-CONNECTOR.1, WIRE-CONNECTOR.10
IN1P: ELECTRODE-CONNECTOR.7, WIRE-CONNECTOR.9
IN2P: ELECTRODE-CONNECTOR.9, WIRE-CONNECTOR.8
IN3P: ELECTRODE-CONNECTOR.11, WIRE-CONNECTOR.7
IN4P: ELECTRODE-CONNECTOR.13, WIRE-CONNECTOR.6
IN5P: ELECTRODE-CONNECTOR.15, WIRE-CONNECTOR.5
IN6P: ELECTRODE-CONNECTOR.17, WIRE-CONNECTOR.4
IN7P: ELECTRODE-CONNECTOR.19, WIRE-CONNECTOR.3
IN8P: ELECTRODE-CONNECTOR.21, WIRE-CONNECTOR.2
unnamed: JP1.1, R1.2

Notes on the sheet:
Fiducials - Top
Fiducials - Bottom
BIAS_ELEC
IN1P
IN2P
IN3P
IN4P
IN5P
IN7P
IN8P
AGND1
AVDD
v 1.0
v0.2
Copyright © 2019 Adam Feuer Released the CERN Open Hardware License v.1.2

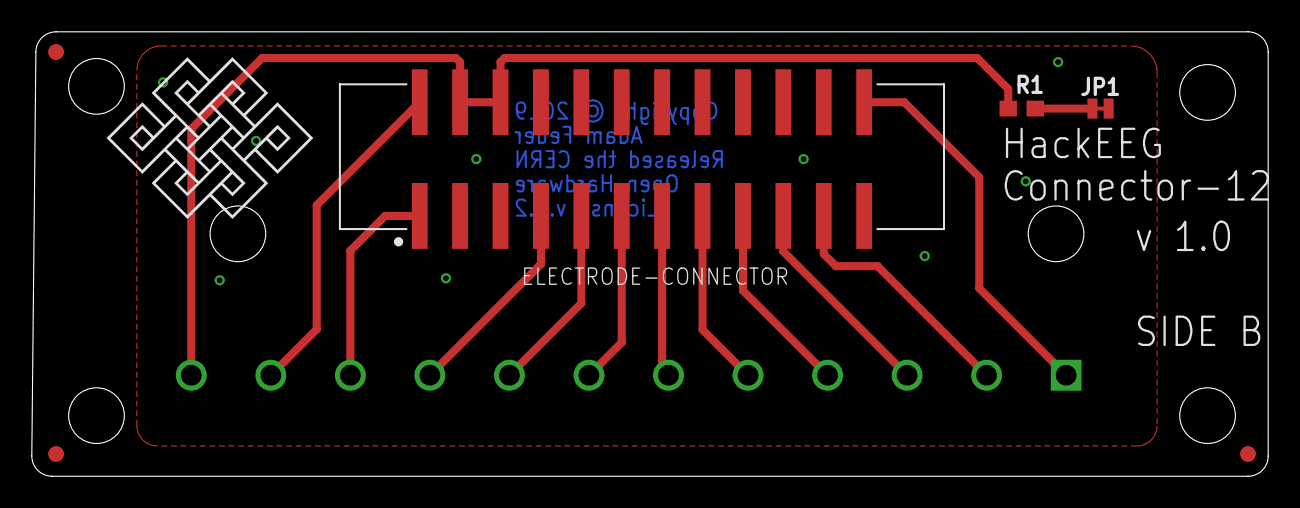
[picture p42: board hackeeg-connector-12.brd from above]

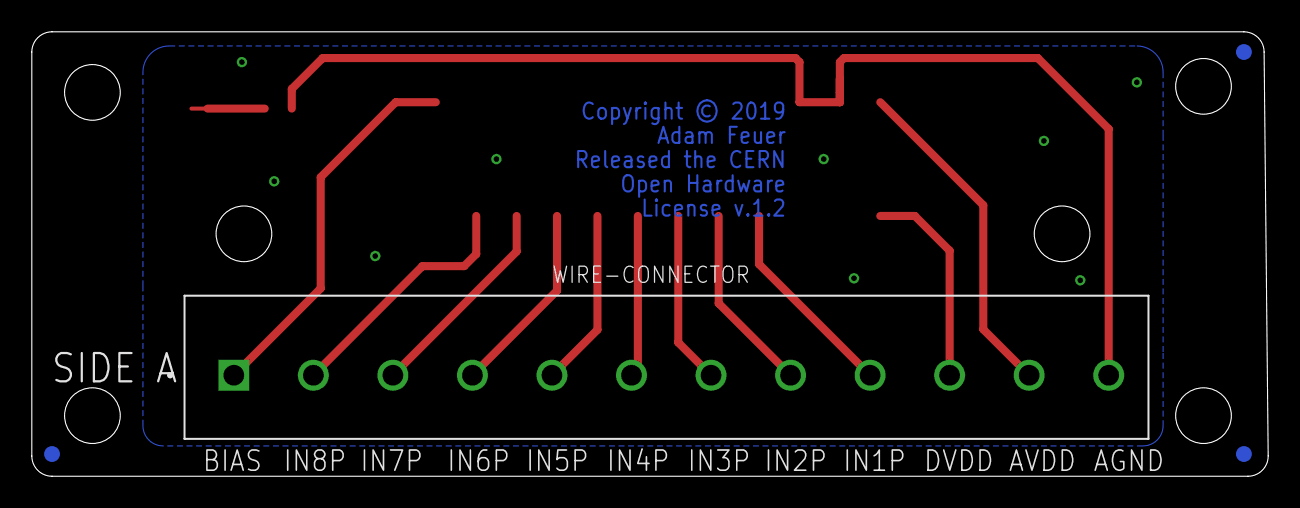
[picture p43: board hackeeg-connector-12.brd from below]

Board: 2 copper layers, 77.7 x 27.9 mm, 11 parts (4 on the bottom side), 14 nets.
