Hobbit13/hackeeg-shield/(commit log)

2022-07-28 Modified version that uses isolated SPI and isolated DC-DC converter (not tested much!)
    To enable use of the EMG shield while the Arduino is galvanically connected to mains (in our scenario since it also containers motor driver controllers).
    Basic communication works, but signal quality is not tested yet.
    Issues:
    - Spikes in signals, probably SPI issues
    - MCU led polarity is wrong
    - AIMTEC isolator doesn't fit well (keep out area is on the wrong side)
    [BOM_2022-06-02.csv, BOM_value_2022-06-02.csv, PnP_hackeeg-shield_back.csv, PnP_hackeeg-shield_front.csv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]
2023-04-21 Patched led, removed header ch1 to 4, added drdy pull up
    [Shield BOM_JLCSMT.xlsx, hackeeg-shield.brd, hackeeg-shield.sch, partslist.csv, partslist.xlsx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]
2023-07-25 added NC res/cap to potentially use the RLD
    Added C and R between 61 and 63 and moved R6 closer to chip, to enable testing with RLD and future patch to enable it.
    [hackeeg-shield.brd, hackeeg-shield.sch]
