Hobbit13/hackeeg-shield/(notices)

Notices in the files:
eagle - Copy/hackeeg-connector-8-vertical.brd:
Copyright © 2020 Adam Feuer
parts and their libraries:
SparkFun-Aesthetics: Licensing: Creative Commons ShareAlike 4.0 International - https://creativecommons.org/licenses/by-sa/4.0
SparkFun-Passives: Licensing: CC v3.0 Share-Alike You are welcome to use this library for commercial purposes.
